khripkinvlan/OvcharkaBoard/Безымянный проект/Безымянный проект.png

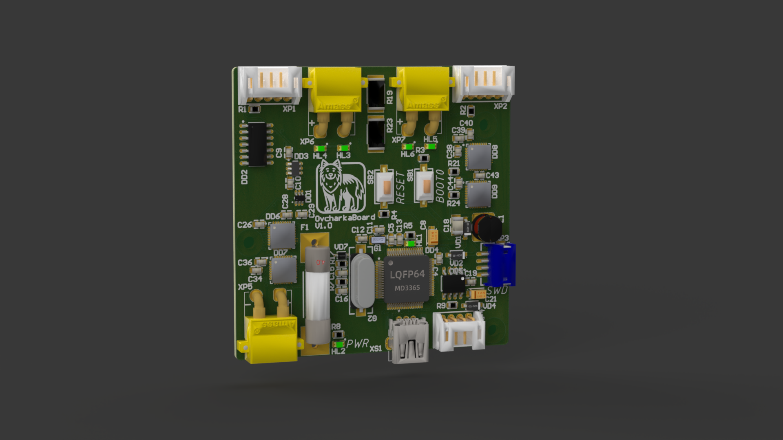
Безымянный проект/Безымянный проект.png
