khripkinvlan/OvcharkaBoard/CubeMxProject/Pinout.xlsx

Pin Nb | PINs | FUNCTIONs | LABELs | Pin Nb | PINs | FUNCTIONs | LABELs
1 | VBAT |  |  | 1 | VBAT
2 | PC13-TAMPER-RTC | GPIO_Output | IND_LED | 2 | PC13-TAMPER-RTC | GPIO_Output | IND_LED
3 | PC14-OSC32_IN | RCC_OSC32_IN |  | 3 | PC14-OSC32_IN
4 | PC15-OSC32_OUT | RCC_OSC32_OUT |  | 4 | PC15-OSC32_OUT
5 | PD0-OSC_IN | RCC_OSC_IN |  | 5 | PD0-OSC_IN | RCC_OSC_IN
6 | PD1-OSC_OUT | RCC_OSC_OUT |  | 6 | PD1-OSC_OUT | RCC_OSC_OUT
7 | NRST | RESET |  | 7 | NRST | RESET
8 | VSSA | GND |  | 8 | VSSA | GND
9 | VDDA | 3V3 |  | 9 | VDDA | 3V3
10 | PA0-WKUP | TIM2_CH1 | ENC2_CH1 | 10 | PA0-WKUP |  | DIR1
11 | PA1 | TIM2_CH2 | ENC2_CH2 | 11 | PA1 |  | DIR2
12 | PA2 | ADC1_IN2 | CS1 | 12 | PA2 | ADC1_IN2 | CS1
13 | PA3 | ADC1_IN3 | CS2 | 13 | PA3 | ADC1_IN3 | CS2
14 | PA4 | GPIO_Output | SPI1_SS1 | 14 | PA4 | GPIO_Output | SPI1_SS1
15 | PA5 | SPI1_SCK |  | 15 | PA5 | SPI1_SCK
16 | PA6 | SPI1_MISO |  | 16 | PA6 | SPI1_MISO
17 | PA7 | SPI1_MOSI |  | 17 | PA7 | SPI1_MOSI
18 | PB0 | TIM3_CH3 | PWM1 | 18 | PB0 | TIM3_CH3 | PWM1
19 | PB1 | TIM3_CH4 | PWM2 | 19 | PB1 | TIM3_CH4 | PWM2
20 | PB2 | GPIO_Output | SPI1_SS2 | 20 | PB2 | GPIO_Output | SPI1_SS2
21 | PB10 | GPIO_Output | SPI1_SS3 | 21 | PB10 | GPIO_Output | SPI1_SS3
22 | PB11 | GPIO_Output | SPI1_SS4 | 22 | PB11 | GPIO_Output | SPI1_SS4
23 | VSS |  |  | 23 | VSS | GND
24 | VDD |  |  | 24 | VDD | 3V3
25 | PB12 | GPIO_Input | NFAULT1L | 25 | PB12 | GPIO_Input | BRIDGESLEEP1
26 | PB13 | GPIO_Input | NFAULT1R | 26 | PB13 | GPIO_Input | BRIDGESLEEP2
27 | PB14 | GPIO_Input | NFAULT2L | 27 | PB14 | GPIO_Input | NFAULTA
28 | PB15 | GPIO_Input | NFAULT2R | 28 | PB15 | GPIO_Input | NFAULTB
29 | PA8 | TIM1_CH1 | ENC1_CH2 | 29 | PA8 | TIM1_CH1 | ENC1_CH1
30 | PA9 | TIM1_CH2 | ENC1_CH1 | 30 | PA9 | TIM1_CH2 | ENC1_CH2
31 | PA10 | GPIO_Output | CAN_MODE | 31 | PA10 | GPIO_Input | ENC1_Z
32 | PA11 | CAN_RX |  | 32 | PA11 | GPIO_Input | ENC2_Z
33 | PA12 | CAN_TX |  | 33 | PA12 |  | DRVOFF1
34 | PA13 | SYS_JTMS-SWDIO |  | 34 | PA13 | SYS_JTMS-SWDIO
35 | VSS |  |  | 35 | VSS
36 | VDD |  |  | 36 | VDD
37 | PA14 | SYS_JTCK-SWCLK |  | 37 | PA14 | SYS_JTCK-SWCLK
38 | PA15 | GPIO_Input | ENC2_Z | 38 | PA15 | TIM2_CH1 | ENC2_CH1
39 | PB3 | GPIO_Input | ENC1_Z | 39 | PB3 | TIM2_CH2 | ENC2_CH2
40 | PB4 | GPIO_Output | 3 | 40 | PB4 | GPIO_Output | DRVOFF2
41 | PB5 | GPIO_Output | DIS1 | 41 | PB5 | GPIO_Output | RS485_Ctrl
42 | PB6 | GPIO_Output | DIR2 | 42 | PB6 | USART1_TX
43 | PB7 | GPIO_Output | DIS2 | 43 | PB7 | USART1_RX
44 | BOOT0 |  |  | 44 | BOOT0
45 | PB8 | TIM4_CH3 | ENC2_CH1_F | 45 | PB8 | TIM4_CH3 | ENC1_CH1_F
46 | PB9 | TIM4_CH4 | ENC1_CH1_F | 46 | PB9 | TIM4_CH4 | ENC2_CH1_F
47 | VSS | GND |  | 47 | VSS | GND
48 | VDD | 3V3 |  | 48 | VDD | 3V3
