khripkinvlan/OvcharkaBoard/FunctionalSchemeEN.png

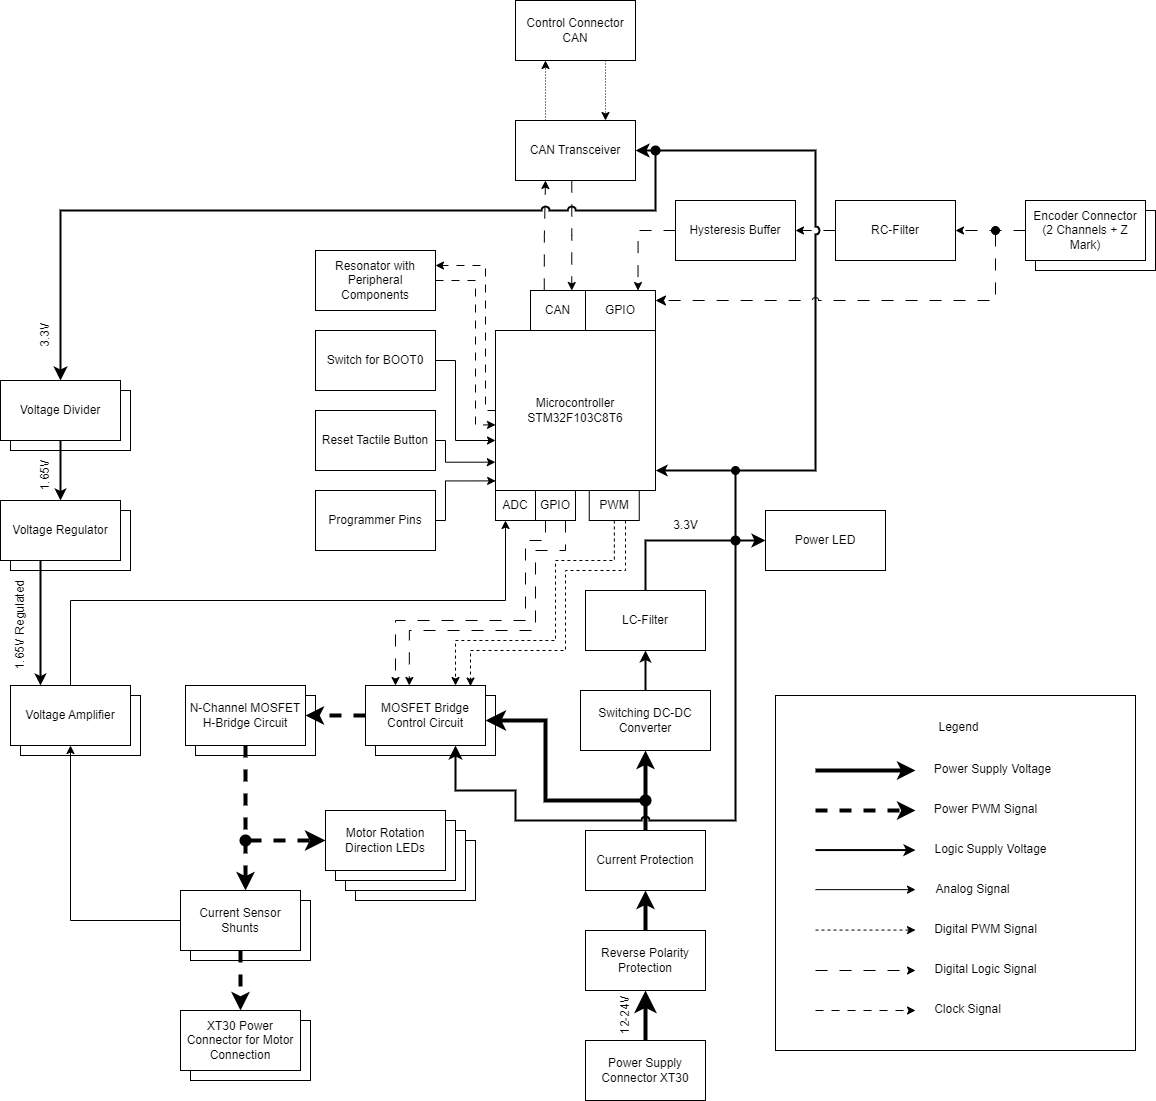
FunctionalSchemeEN.png
