khripkinvlan/OvcharkaBoard/FunctionalSchemeRU.png

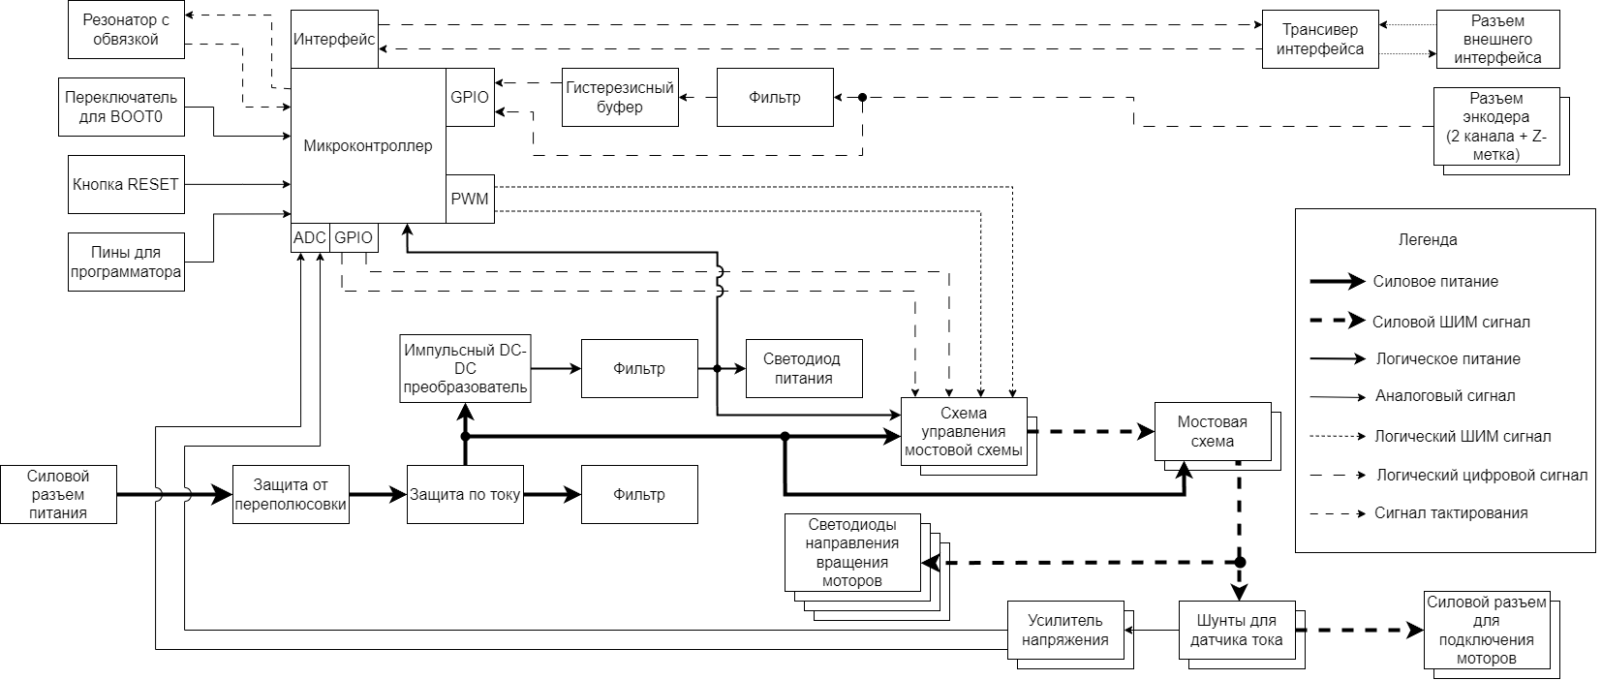
FunctionalSchemeRU.png
