khripkinvlan/OvcharkaBoard/OvcharkaBoard.png

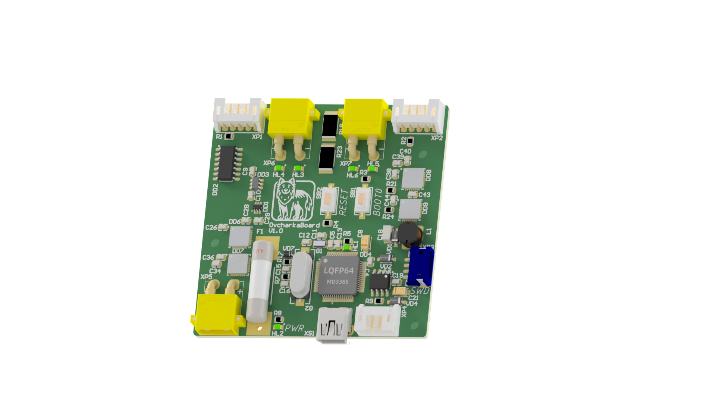
OvcharkaBoard.png
