khripkinvlan/OvcharkaBoard/Schemes/sosa-1.png

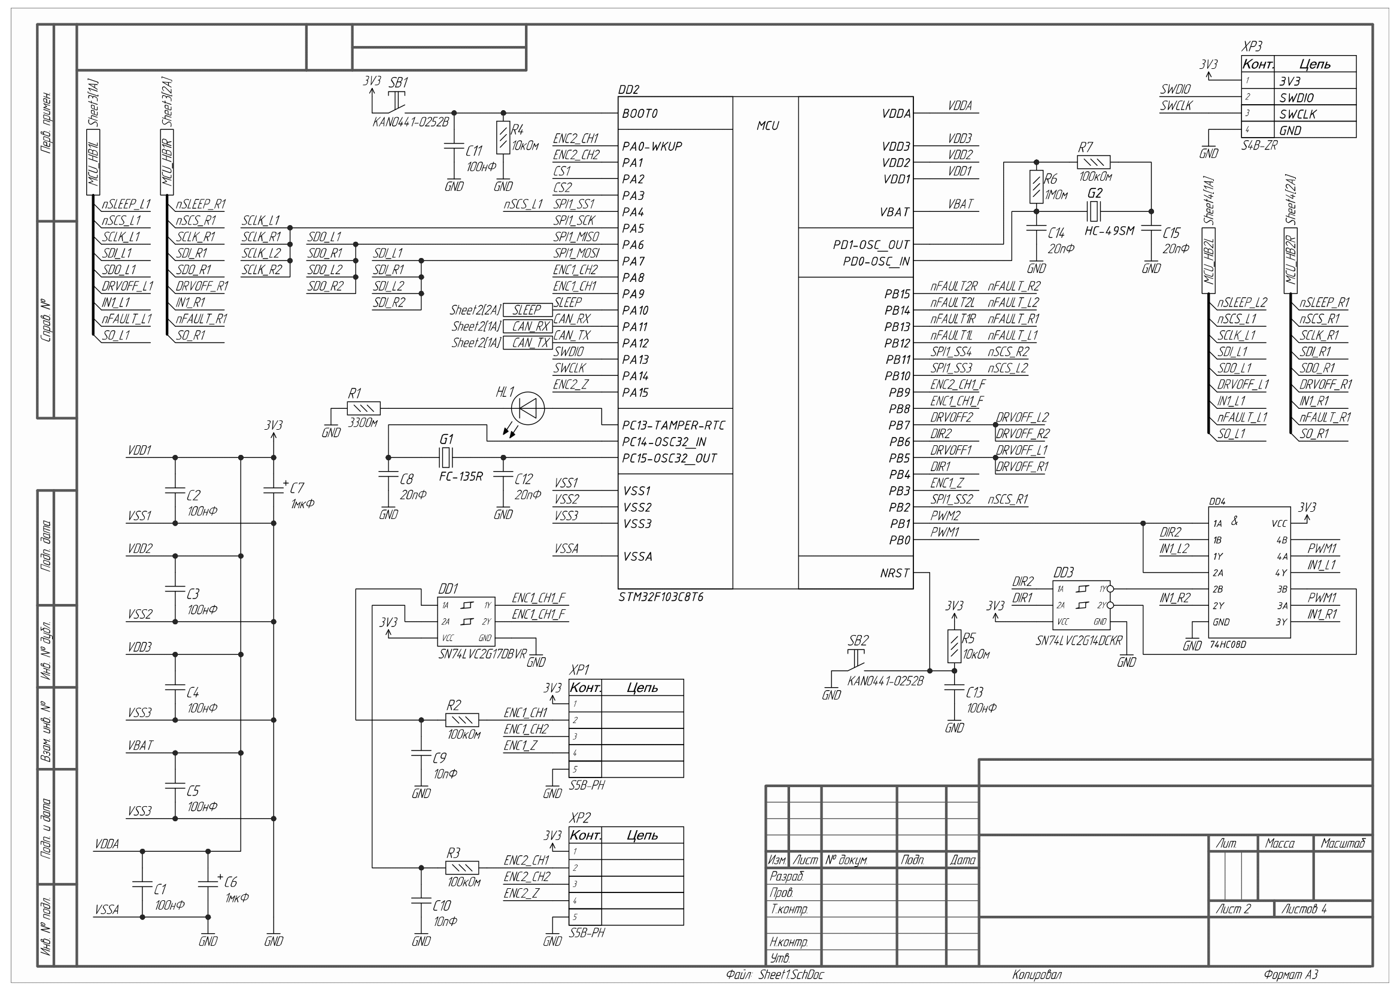
Schemes/sosa-1.png
