khripkinvlan/OvcharkaBoard/Без имени.png

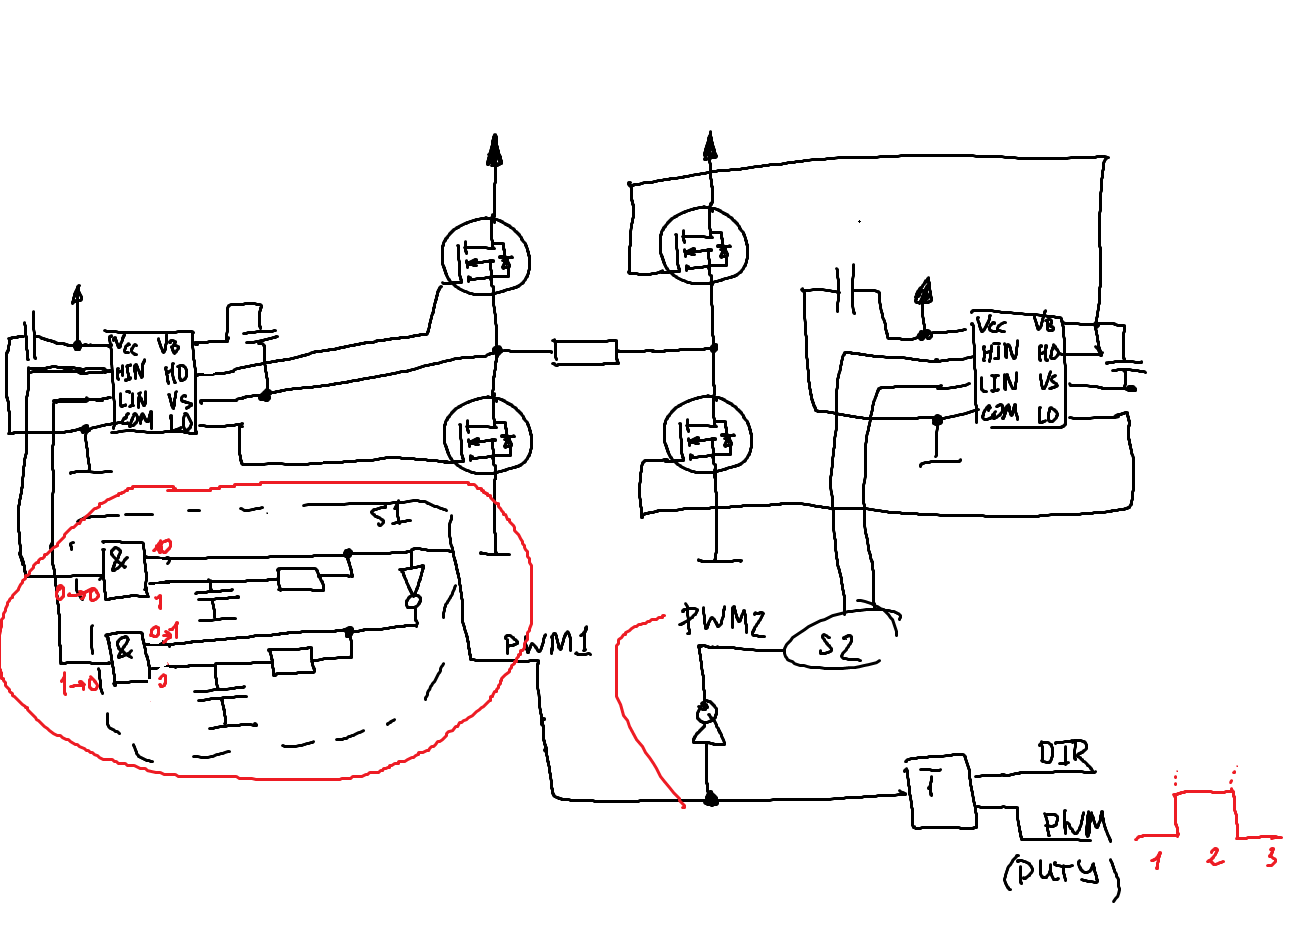
Без имени.png
