khripkinvlan/OvcharkaBoard/Инвентаризация 23.02.2025.xlsx

Line # | Name | Description | Designator | Quantity | 2BoardRequire | InStock | Extra | В корзине | Price | Подходит ли посадочное место | Правильная ли распиновка
 | AMS1117-3.3 | Линейный регулятор с малым падением напряжения, 1А, 3.3В [SOT-223] | A1 | 1 | 2 | 6 | 4 |  |  |  |  | 6
 | 0,1мкФ 50В | Конденсатор керамический, типоразмера 0603 | C1, C2, C3, C4, C5, C6, C13, C14, C19, C24, C27, C28, C36, C39, C44 | 15 | 30 | 30 | 0 |  |  |  |  | 2
 | 1мкФ | Описание свойств компонента | C7, C8, C21 | 3 | 6 | 4 | -2 | 8 |  |  |  | 1.333333333
 | 1мкФ 50В | Описание свойств компонента | C25, C26 ,C29, C33, C34, C35, C37, C38, C40, C41, C42, C43 | 11 | 22 | 15 | -7 |  |  |  |  | 1.363636364
 | 10пФ | Конденсатор керамический, типоразмера 0603 | C9, C10 | 2 | 4 | 4 | 0 |  |  |  |  | 2
 | 20пФ | Конденсатор керамический, типоразмера 0603 | C11, C12, C15, C16 | 4 | 8 | 6 | -2 |  |  |  |  | 1.5
 | 10мкФ 50В | Конденсатор керамический, типоразмера 1206 | C17, C18, C22, C23, C30, C31, C32 | 7 | 14 | 13 | -1 |  |  |  |  | 1.857142857
 | 3.9нФ | Конденсатор керамический, типоразмера 0603 | C20 | 1 | 2 | 3 | 1 |  |  |  |  | 3
 | MC34063S | The MC34063is a monolithic regulator subsystem, intended for use as DC to DC converter. This device contains a temperature compensated band gap reference, a duty-cycle control oscillator, driver and high current output switch. It can be used for step down, step-up or inverting switching regulators as well as for series pass regulators. | DA1 | 1 | 2 | 8 | 6 |  |  | Да |  | 8
 | SN74LVC2G14DCKR | Сдвоенный инвертор с триггером Шмидта | DD1 | 1 | 2 | 3 | 1 |  |  |  |  | 3
 | 74HC08D | Логическая ИС, QUAD 2-INPUT AND GATE | DD2 | 1 | 2 | 3 | 1 |  |  |  |  | 3
 | SN74LVC2G17DBVR | Сдвоенный буфер с триггером Шмитта на входе | DD3 | 1 | 2 | 3 | 1 |  |  |  |  | 3
 | STM32F103RBT6 | Микроконтроллер 32-Бит, Cortex-M3, 72МГц, 128КБ Flash, USB, CAN [LQFP-64] | DD4 | 1 | 2 | 1 | -1 |  |  |  |  | 1
 | SP3485EN-L/TR | Трансивер RS485 Half-Duplex 1/1 | DD5 | 1 | 2 | 0 | -2 |  |  | Да |  | 0
 | DRV8106SQRHBRQ1 | Automotive, 40-V, half-bridge Smart Gate Driver w/offline diagnostics and inline current sense amp. | DD6, DD7, DD8, DD9 | 4 | 8 | 10 | 2 |  |  |  |  | 2.5
 | ва | Предохранитель плавкий 5x20 | F1 | 1 | 2 | 1 | -1 |  |  |  |  | 1
 | FC-135R | Кварцевый резонатор 32,768 кГц; SMD | G1 | 1 | 2 | 2 | 0
 | HC-49SM | Кварцевый резонатор 8 МГц; SMD | G2 | 1 | 2 | 2 | 0 |  |  |  |  | 2
 | 3 | Светодиод SMD 0805=2x1.3мм, красный, 28мкд, 130град, прозрачная линза; Q-15575B СД SMD02013C2\кр\ 28,5\130\пр\FYLS- 0805HD\FORYARD | HL1, HL2, HL3, HL4, HL5, HL6 | 6 | 12 | 88 | 76 |  |  |  |  | 14.66666667
 | 47мкГн | Дросель, 5x5 | L1 | 1 | 2 | 13 | 11 |  |  |  |  | 13
 | 100кОм | Резистор, типоразмера 0603 | R1, R2, R7, R15 | 4 | 8 | 5 | -3 |  |  |  |  | 1.25
 | 10кОм | Резистор, типоразмера 0603 | R3, R4, R16, R17, R20, R21, R24 | 7 | 14 | 9 | -5 |  |  |  |  | 1.285714286
 | 1МОм | Резистор, типоразмера 0603 | R6 | 1 | 2 | 8 | 6 |  |  |  |  | 8
 | 330Ом | Резистор, типоразмера 0603 | R5,R8 | 2 | 4 | 8 | 4 |  |  |  |  | 4
 | 120Ом | Резистор, типоразмера 0603 | R9 | 1 | 2 | 17 | 15 |  |  |  |  | 17
 | 4.7кОм | Резистор, типоразмера 0603 | R10, R11 | 2 | 4 | 18 | 14 |  |  |  |  | 9
 | 8.2кОм 1% | Резистор, типоразмера 0603 | R12 | 1 | 2 | 9 | 7 |  |  |  |  | 9
 | 4,99 кОм 1% | Резистор, типоразмера 0603 | R13 | 1 | 2 | 9 | 7 |  |  |  |  | 9
 | 0.2Ом 1% | Резистор, типоразмера 2512 | R14 | 1 | 2 | 4 | 2 |  |  |  |  | 4
 | 7.5мОм | Резистор, типоразмера 2512 | R18, R22 | 2 | 4 | 48 | 44 |  |  |  |  | 24
 | 1.8кОм | Резистор, типоразмера 2512 | R19, R23 | 2 | 4 | 4 | 0 |  |  |  |  | 2
 | KAN0441-0252B | Описание свойств компонента | SB1, SB2 | 2 | 4 | 100 | 96 |  |  |  |  | 50
 | USBLC6-2 | Защита интерфейса USB от электростатических разрядов [SOT-23-6] | V1 | 1 | 2 | 3 | 1 |  |  |  |  | 3
 | 1N5819W | Диод Шоттки, 40 В, 0.35 А, SOD-123 | VD1, VD2, VD4, VD5 | 4 | 8 | 46 | 38 |  |  | Да |  | #REF!
 | ESDCAN24-2BLY | Устройство защиты CAN шины от ESD, 2 защитных диода [SOT-23-3] | VD3 | 1 | 2 | 4 | 2 |  |  |  |  | 4
 | ESD5Z5.0T1G | Устройство защиты от ESD, защитный диод, 5В [SOD-523] | VD6 | 1 | 2 | 10 | 8 |  |  |  |  | 10
 | BZX384-C18 | Стабилитрон 18В 0.3Вт [SOD-323] | VD7 | 1 | 2 | 66 | 64 |  |  |  |  | 66
 | STD10PF06T4-VB | Транзистор P-MOSFET 60В 30А 34Вт [D-PAK] | VT1 | 1 | 2 | 9 | 7 |  |  |  |  | 9
 | IRF7854TRPBF | Транзистор, HEXFET, N-канал, 80В, 10А [SOIC-8] | VT2, VT3, VT4, VT5, VT6, VT7, VT8, VT9 | 8 | 16 | 4 | -12 |  |  | Да |  | 0.5
 | S5B-PH | JST PH 5pin 2 mm pitch; horizontal; through hole OR full smd; S5B-PH-SM4-TB | XP1, XP2 | 2 | 4 | 16 | 12 |  |  | Да |  | 8
 | S4B-ZR | JST ZH 4pin 1.5 mm pitch; horizontal; through hole OR full smd; S4B-ZR | XP3 | 1 | 2 | 15 | 13 |  |  |  |  | 15
 | S4B-PH | JST PH 4pin 2 mm pitch; horizontal; through hole OR full smd; S4B-PH-SM4-TB | XP4 | 1 | 2 | 4 | 2 |  |  |  |  | 4
 | XT30PW-M | Socket; DC supply; XT30; male; PIN: 2; on PCBs; THT; yellow; 15A; 500V | XP5, XP6, XP7 | 3 | 6 | 1 | -5 |  |  |  |  | 0.3333333333
 | 0548190519 | USB - mini B USB 2.0 OTG Receptacle Connector 5 Position Through Hole, Right Angle | XS1 | 1 | 2 | 5 | 3 |  |  |  |  | 5
 | 470 Ом | Резистор, типоразмера 0603 | R8 | 1 | 2 | 7 | 5 |  |  |  |  | 7
