khripkinvlan/OvcharkaBoard/bomchik.xlsx

Line # | Name | Description | Designator | Quantity | 2BoardRequire | Bought | Extra | Supplier | Price | Подходит ли посадочное место | Правильная ли распиновка
 | 100нФ | Конденсатор керамический, типоразмера 0603 | C1, C2, C3, C4, C5, C9, C13, C19 | 8 | 16 |  | -16 |  |  |  |  | 0
 | 1мкФ | Описание свойств компонента | C6, C7, C20 | 3 | 6 |  | -6 |  |  |  |  | 0
 | 20пФ | Конденсатор керамический, типоразмера 0603 | C8, C12, C14, C15 | 4 | 8 |  | -8 |  |  |  |  | 0
 | 10пФ | Конденсатор керамический, типоразмера 0603 | C10, C11 | 2 | 4 |  | -4 |  |  |  |  | 0
 | 10мкФ 50В | Конденсатор керамический, типоразмера 1206 | C16, C17, C21, C22, C28, C29, C30 | 7 | 14 |  | -14 |  |  |  |  | 0
 | 3.9нФ | Конденсатор керамический, типоразмера 0603 | C18 | 1 | 2 |  | -2 |  |  |  |  | 0
 | 1мкФ 6.3В | Конденсатор керамический, типоразмера 0603 | C23, C24, C31, C32, C35, C36, C39, C40 | 8 | 16 |  | -16 |  |  |  |  | 0
 | 0,1мкФ 50 В | Конденсатор керамический, типоразмера 0603 | C25, C26, C34, C37, C42 | 5 | 10 |  | -10 |  |  |  |  | 0
 | 1мкФ 16 В | Конденсатор керамический, типоразмера 0603 | C27, C33, C38, C41 | 4 | 8 |  | -8 |  |  |  |  | 0
 | MC34063S | The MC34063is a monolithic regulator subsystem, intended for use as DC to DC converter. This device contains a temperature compensated band gap reference, a duty-cycle control oscillator, driver and high current output switch. It can be used for step down, step-up or inverting switching regulators as well as for series pass regulators. | DA1 | 1 | 2 | 10 | 8 | Aliexpress |  | Да |  | 10
 | SN74LVC2G17DBVR | Сдвоенный буфер с триггером Шмитта на входе | DD1 | 1 | 2 |  | -2 |  |  |  |  | 0
 | STM32F103C8T6 | Medium-density performance line Arm®-based 32-bit MCU with 64 or 128 KB Flash, USB, CAN, 7 timers, 2 ADCs, 9 com. interfaces | DD2 | 1 | 2 | 10 | 8 | Aliexpress |  | Да |  | 10
 | SN74LVC2G14DCKR | Сдвоенный инвертор с триггером Шмидта | DD3 | 1 | 2 |  | -2 |  |  |  |  | 0
 | 74HC08D | Логическая ИС, QUAD 2-INPUT AND GATE | DD4 | 1 | 2 |  | -2 |  |  |  |  | 0
 | SP3485EN-L/TR | Трансивер RS485 Half-Duplex 1/1 | DD5 | 1 | 2 | 5 | 3 | ТомЭлектрон |  | Да |  | 5
 | SN74HC148DR | Шифратор с 8-и до 3-х линий передачи данных [SO-16] | DD6 | 1 | 2 |  | -2 |  |  |  |  | 0
 | DRV8106SQRHBRQ1 | Automotive, 40-V, half-bridge Smart Gate Driver w/offline diagnostics and inline current sense amp. | DD7, DD8, DD9, DD10 | 4 | 8 |  | -8 |  |  |  |  | 0
 | ва | Предохранитель плавкий 5x20 | F1 | 1 | 2 |  | -2 |  |  |  |  | 0
 | FC-135R | Кварцевый резонатор 32,768 кГц; SMD | G1 | 1 | 2 |  | -2 |  |  |  |  | 0
 | HC-49SM | Кварцевый резонатор 8 МГц; SMD | G2 | 1 | 2 | 3 | 1 | ТомЭлектрон |  |  |  | 3
 | 3 | Светодиод оранжевый SMD 0805=2x1.3мм, 70мКд, 130°, 625нм (Orange); №7339 o СД SMD02013C2\оран\ 70\130\пр\FYLS-0805UEC\ | HL1 | 1 | 2 | 100 | 98 |  |  |  |  | 100
 | 3 | Светодиод SMD 0805=2x1.3мм, красный, 28мкд, 130град, прозрачная линза; Q-15575B СД SMD02013C2\кр\ 28,5\130\пр\FYLS- 0805HD\FORYARD | HL2 | 1 | 2 | 100 | 98 |  |  |  |  | 100
 | 3 | Светодиод SMD 0805=2x1.3мм, красный, 28мкд, 130град, прозрачная линза; Q-15575B СД SMD02013C2\кр\ 28,5\130\пр\FYLS- 0805HD\FORYARD | HL3, HL4, HL5, HL6 | 4 | 8 | 100 | 92 |  |  |  |  | 25
 | 47мкГн | Дросель, типоразмера 2010 | L1 | 1 | 2 |  | -2 |  |  |  |  | 0
 | 330Ом | Резистор, типоразмера 0603 | R1, R8 | 2 | 4 |  | -4 |  |  |  |  | 0
 | 100кОм | Резистор, типоразмера 0603 | R2, R3, R7 | 3 | 6 |  | -6 |  |  |  |  | 0
 | 10кОм | Резистор, типоразмера 0603 | R4, R5, R15, R16, R19, R20, R23 | 7 | 14 |  | -14 |  |  |  |  | 0
 | 1МОм | Резистор, типоразмера 0603 | R6 | 1 | 2 |  | -2 |  |  |  |  | 0
 | 120Ом | Резистор, типоразмера 0603 | R9 | 1 | 2 |  | -2 |  |  |  |  | 0
 | 8.2кОм 1% | Резистор, типоразмера 0603 | R10 | 1 | 2 |  | -2 |  |  |  |  | 0
 | 4.7кОм | Резистор, типоразмера 0603 | R11, R12 | 2 | 4 |  | -4 |  |  |  |  | 0
 | 5кОм 1% | Резистор, типоразмера 0603 | R13 | 1 | 2 |  | -2 |  |  |  |  | 0
 | 0.2Ом 1% | Резистор, типоразмера 2512 | R14 | 1 | 2 |  | -2 |  |  |  |  | 0
 | 7.5мОм | Резистор, типоразмера 2512 | R17, R21 | 2 | 4 | 50 | 46 |  |  |  |  | 25
 | 1.8кОм | Резистор, типоразмера 2512 | R18, R22 | 2 | 4 |  | -4 |  |  |  |  | 0
 | KAN0441-0252B | Описание свойств компонента | SB1, SB2 | 2 | 4 |  | -4 |  |  |  |  | 0
 | 1N5819W | Диод Шоттки, 40 В, 0.35 А, SOD-123 | VD1, VD2, VD4 | 3 | 6 | 50 | 44 |  |  | Да |  | 16.66666667
 | ESDCAN24-2BLY | Устройство защиты CAN шины от ESD, 2 защитных диода [SOT-23-3] | VD3 | 1 | 2 |  | -2 |  |  |  |  | 0
 | BZX384-C18 | Стабилитрон 18В 0.3Вт [SOD-323] | VD5 | 1 | 2 |  | -2 |  |  |  |  | 0
 | STD10PF06T4-VB | Транзистор P-MOSFET 60В 30А 34Вт [D-PAK] | VT1 | 1 | 2 |  | -2 |  |  |  |  | 0
 | IRF7854TRPBF | Транзистор, HEXFET, N-канал, 80В, 10А [SOIC-8] | VT2, VT3, VT4, VT5, VT6, VT7, VT8, VT9 | 8 | 16 | 20 | 4 |  |  | Да |  | 2.5
 | S5B-PH | JST PH 5pin 2 mm pitch; horizontal; through hole OR full smd; S5B-PH-SM4-TB | XP1, XP2 | 2 | 4 | 20 | 16 | Aliexpress |  |  |  | 10
 | S4B-ZR | JST ZH 4pin 1.5 mm pitch; horizontal; through hole OR full smd; S4B-ZR | XP3 | 1 | 2 | 15 | 13 | Aliexpress |  |  |  | 15
 | S4B-PH | JST PH 4pin 2 mm pitch; horizontal; through hole OR full smd; S4B-PH-SM4-TB | XP4 | 1 | 2 | 10 | 8 |  |  |  |  | 10
 | XT30PW-M | Socket; DC supply; XT30; male; PIN: 2; on PCBs; THT; yellow; 15A; 500V | XP5, XP6, XP7 | 3 | 6 | 7 | 1 |  |  |  |  | 2.333333333
 | XT30-M |  |  |  |  | 10 | 10 | Aliexpress
 | XT30-F |  |  |  |  | 10 | 10 | Aliexpress
 | AMS1117-3.3 | Линейный регулятор с малым падением напряжения, 1А, 3.3В [SOT-223] | A1 | 1
