khripkinvlan/OvcharkaBoard/OvcharkaBoard/Project Outputs for OvcharkaBoard/cam.dxf

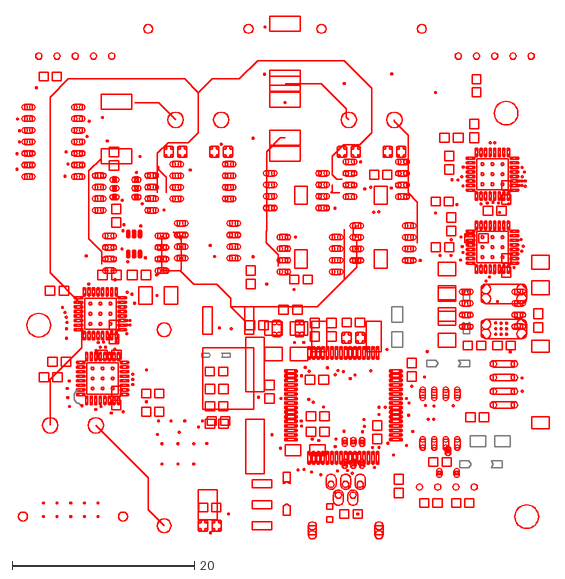
[picture p12: CAD file, 2025-01-27]
OvcharkaBoard/Project Outputs for OvcharkaBoard/cam.dxf
58.5 x 57.3
