khripkinvlan/OvcharkaBoard/Schemes/Schemes.pdf

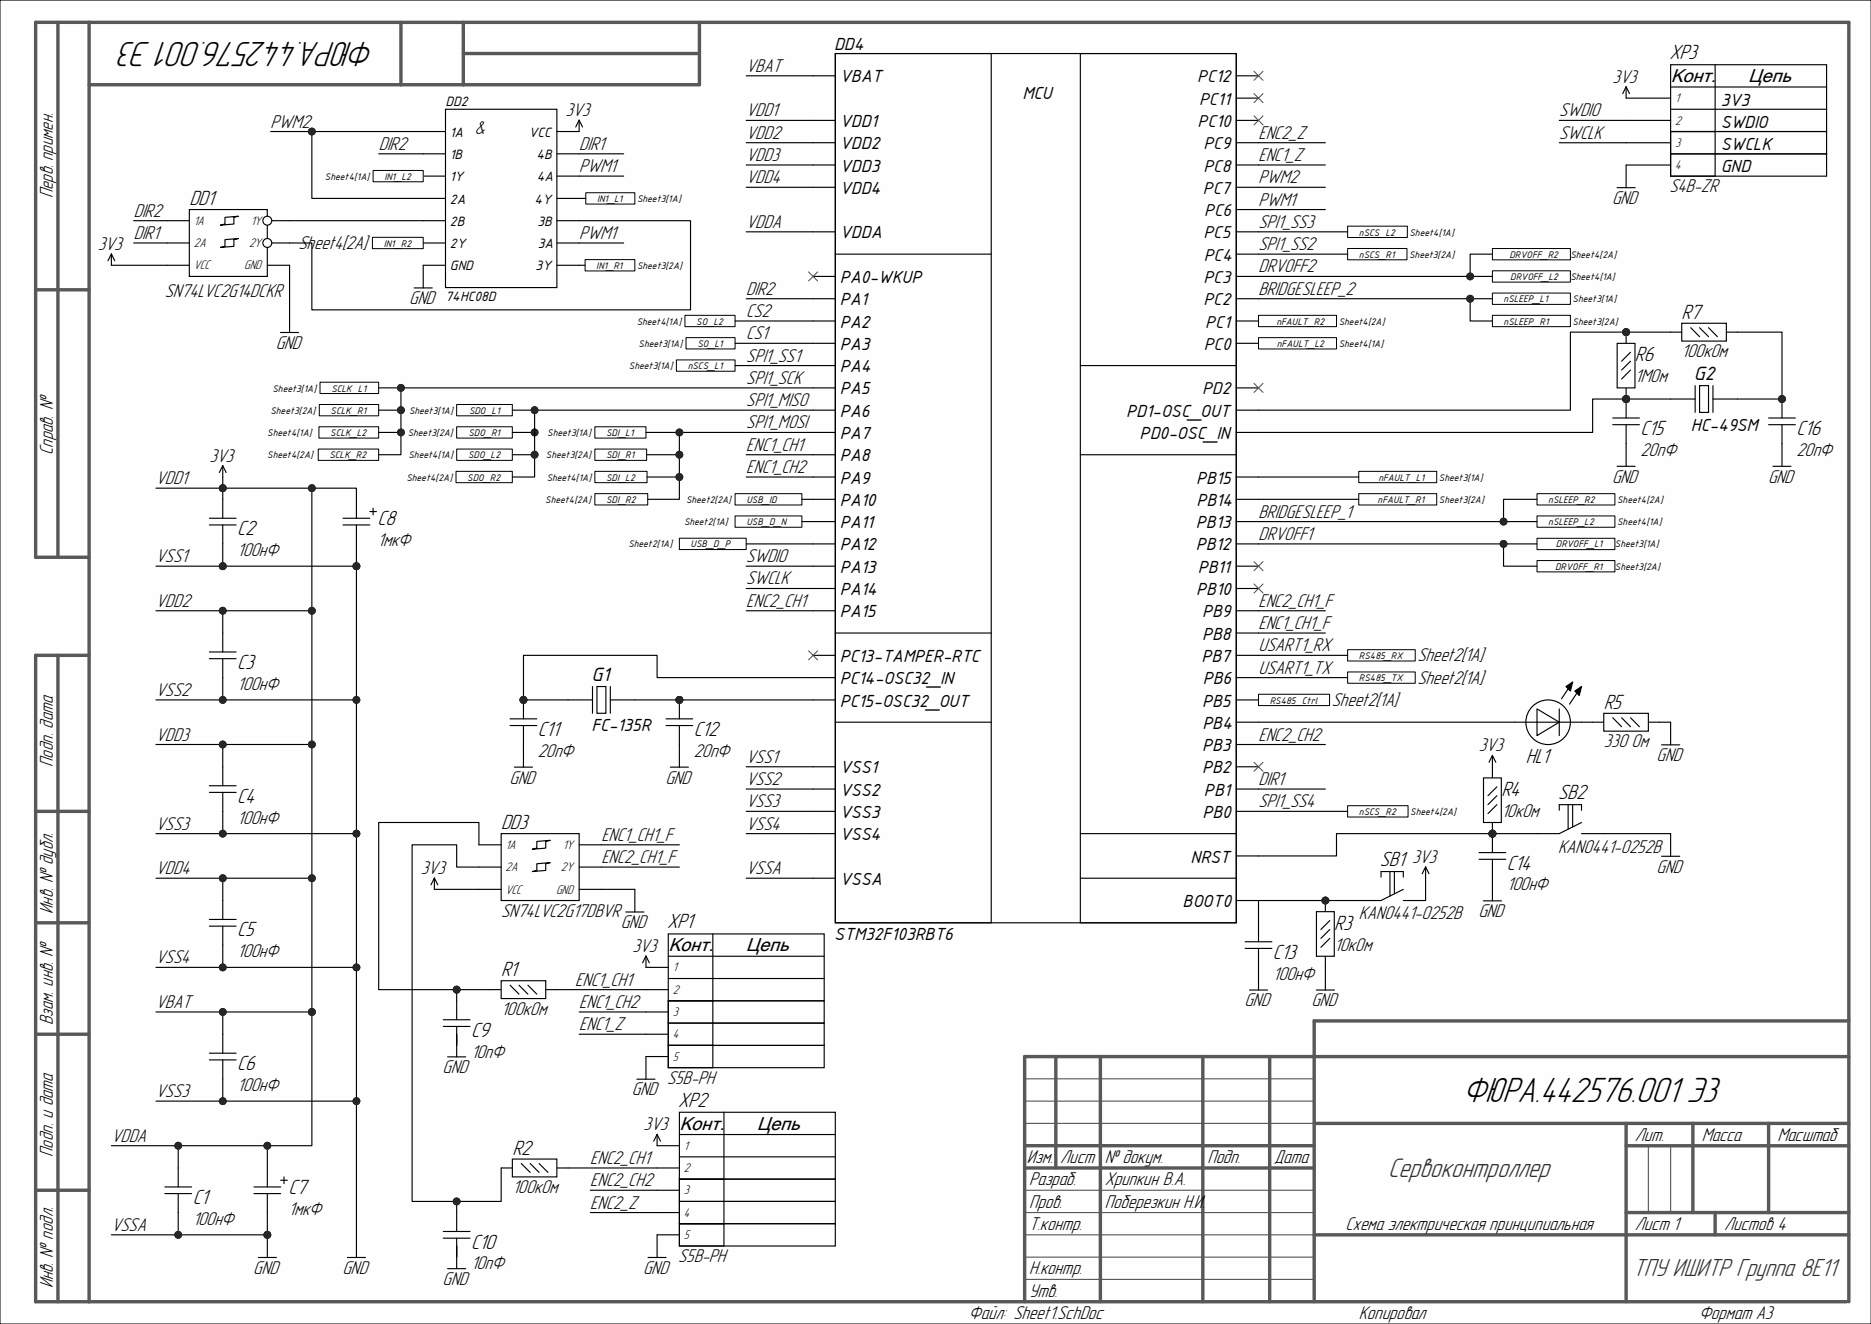
[picture p13: page 1]

ФЮРА.442576.001 Э3

Сервоконтроллер Схема электрическая принципиальная | Лит. | Масса | Масштаб

Изм. Лист № докум. | | Подп. | Дата
Разраб. | Хрипкин В.А.

Т.контр. | Лист 1 4 | Листов

Н.контр.
Утв.

ТПУ ИШИТР Группа 8Е11

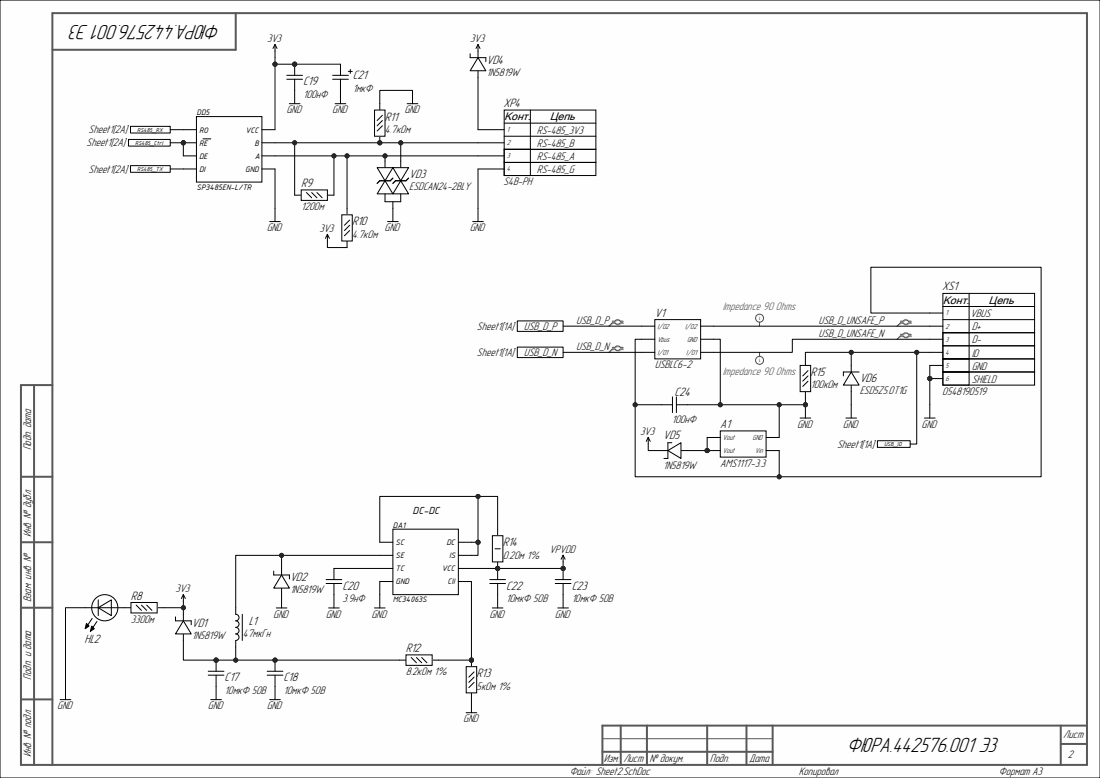
[picture p14: page 2]

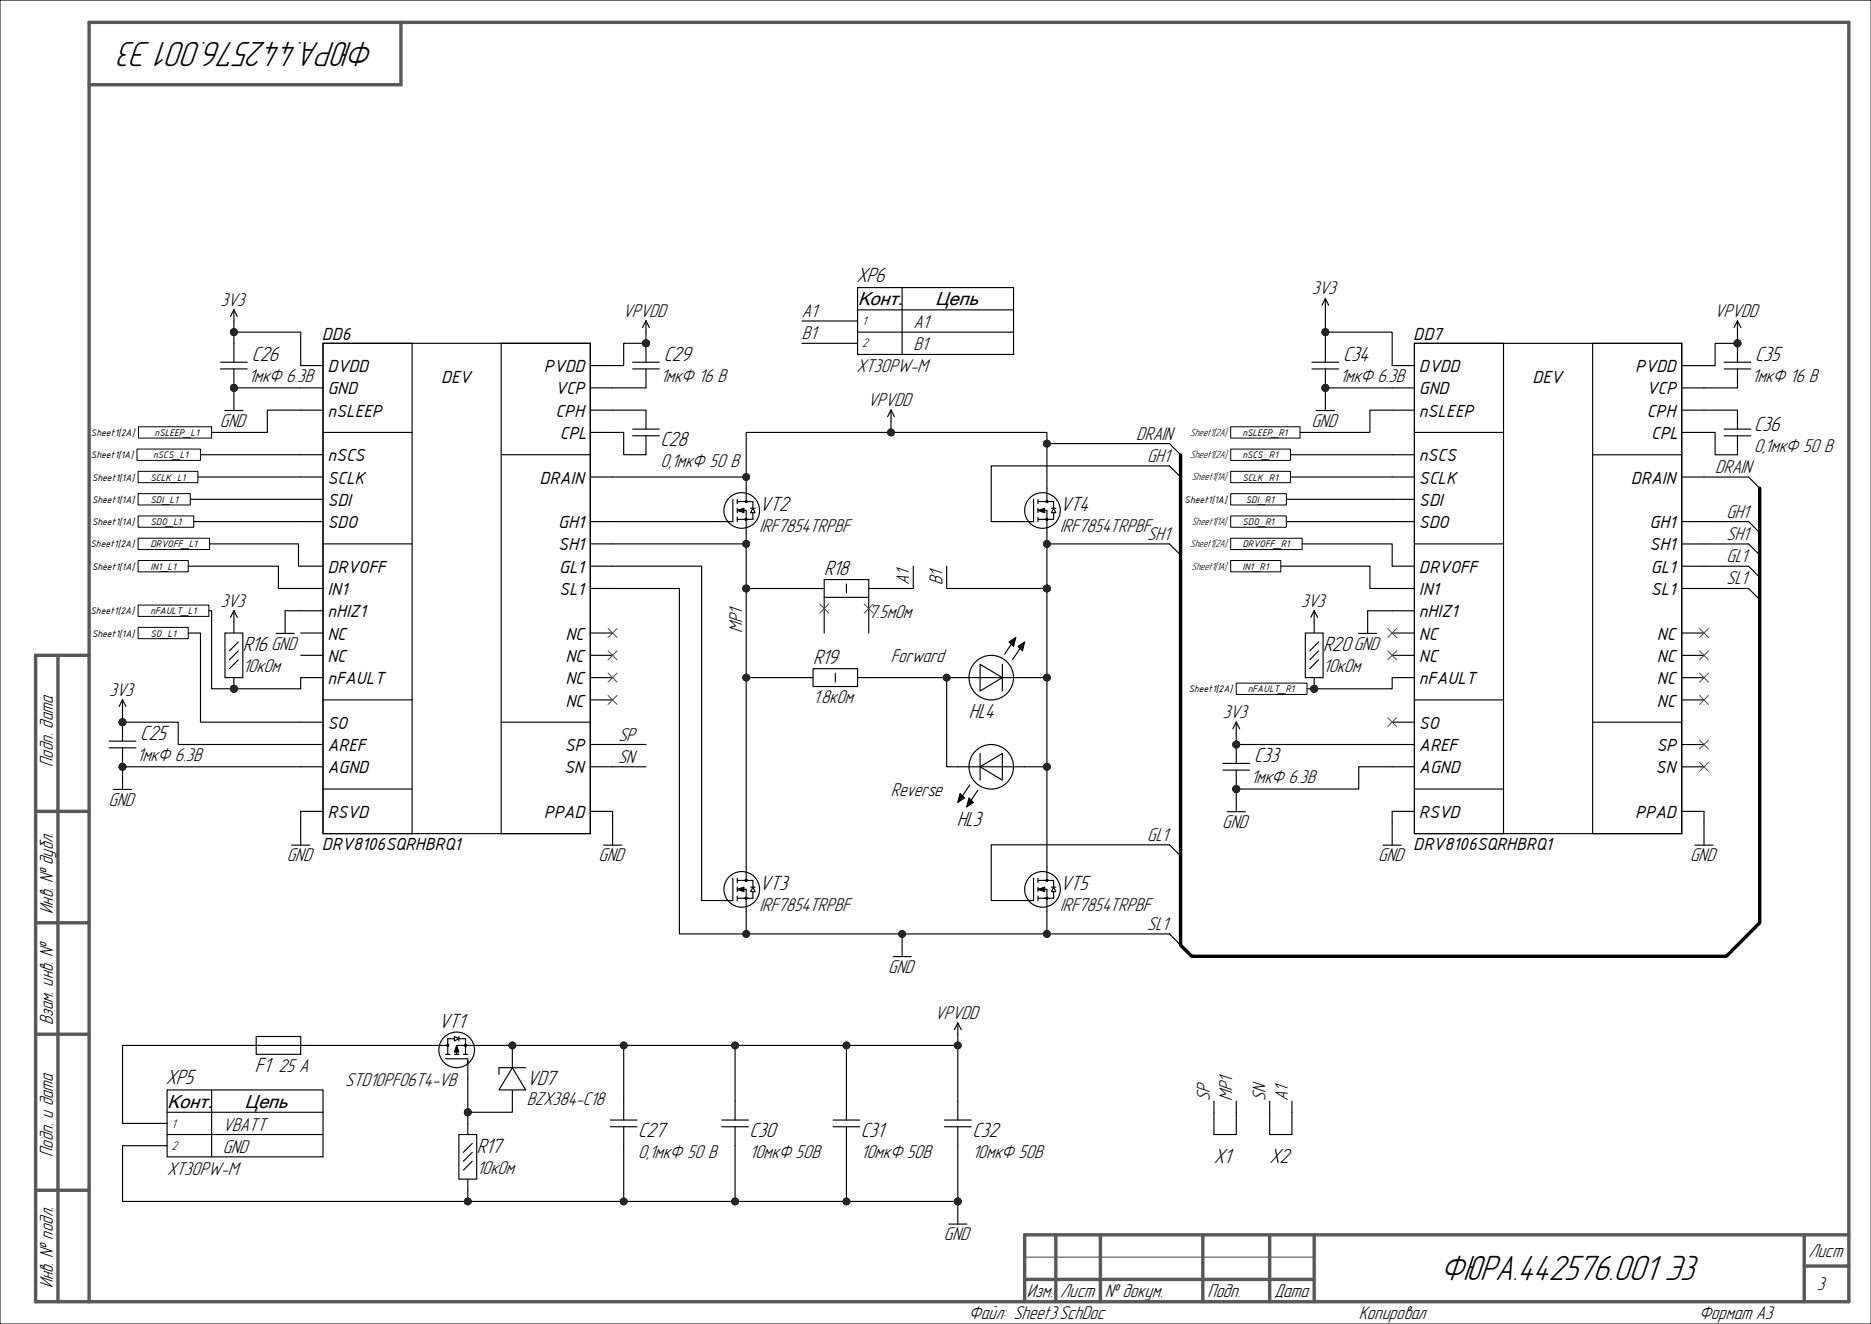
[picture p15: page 3]

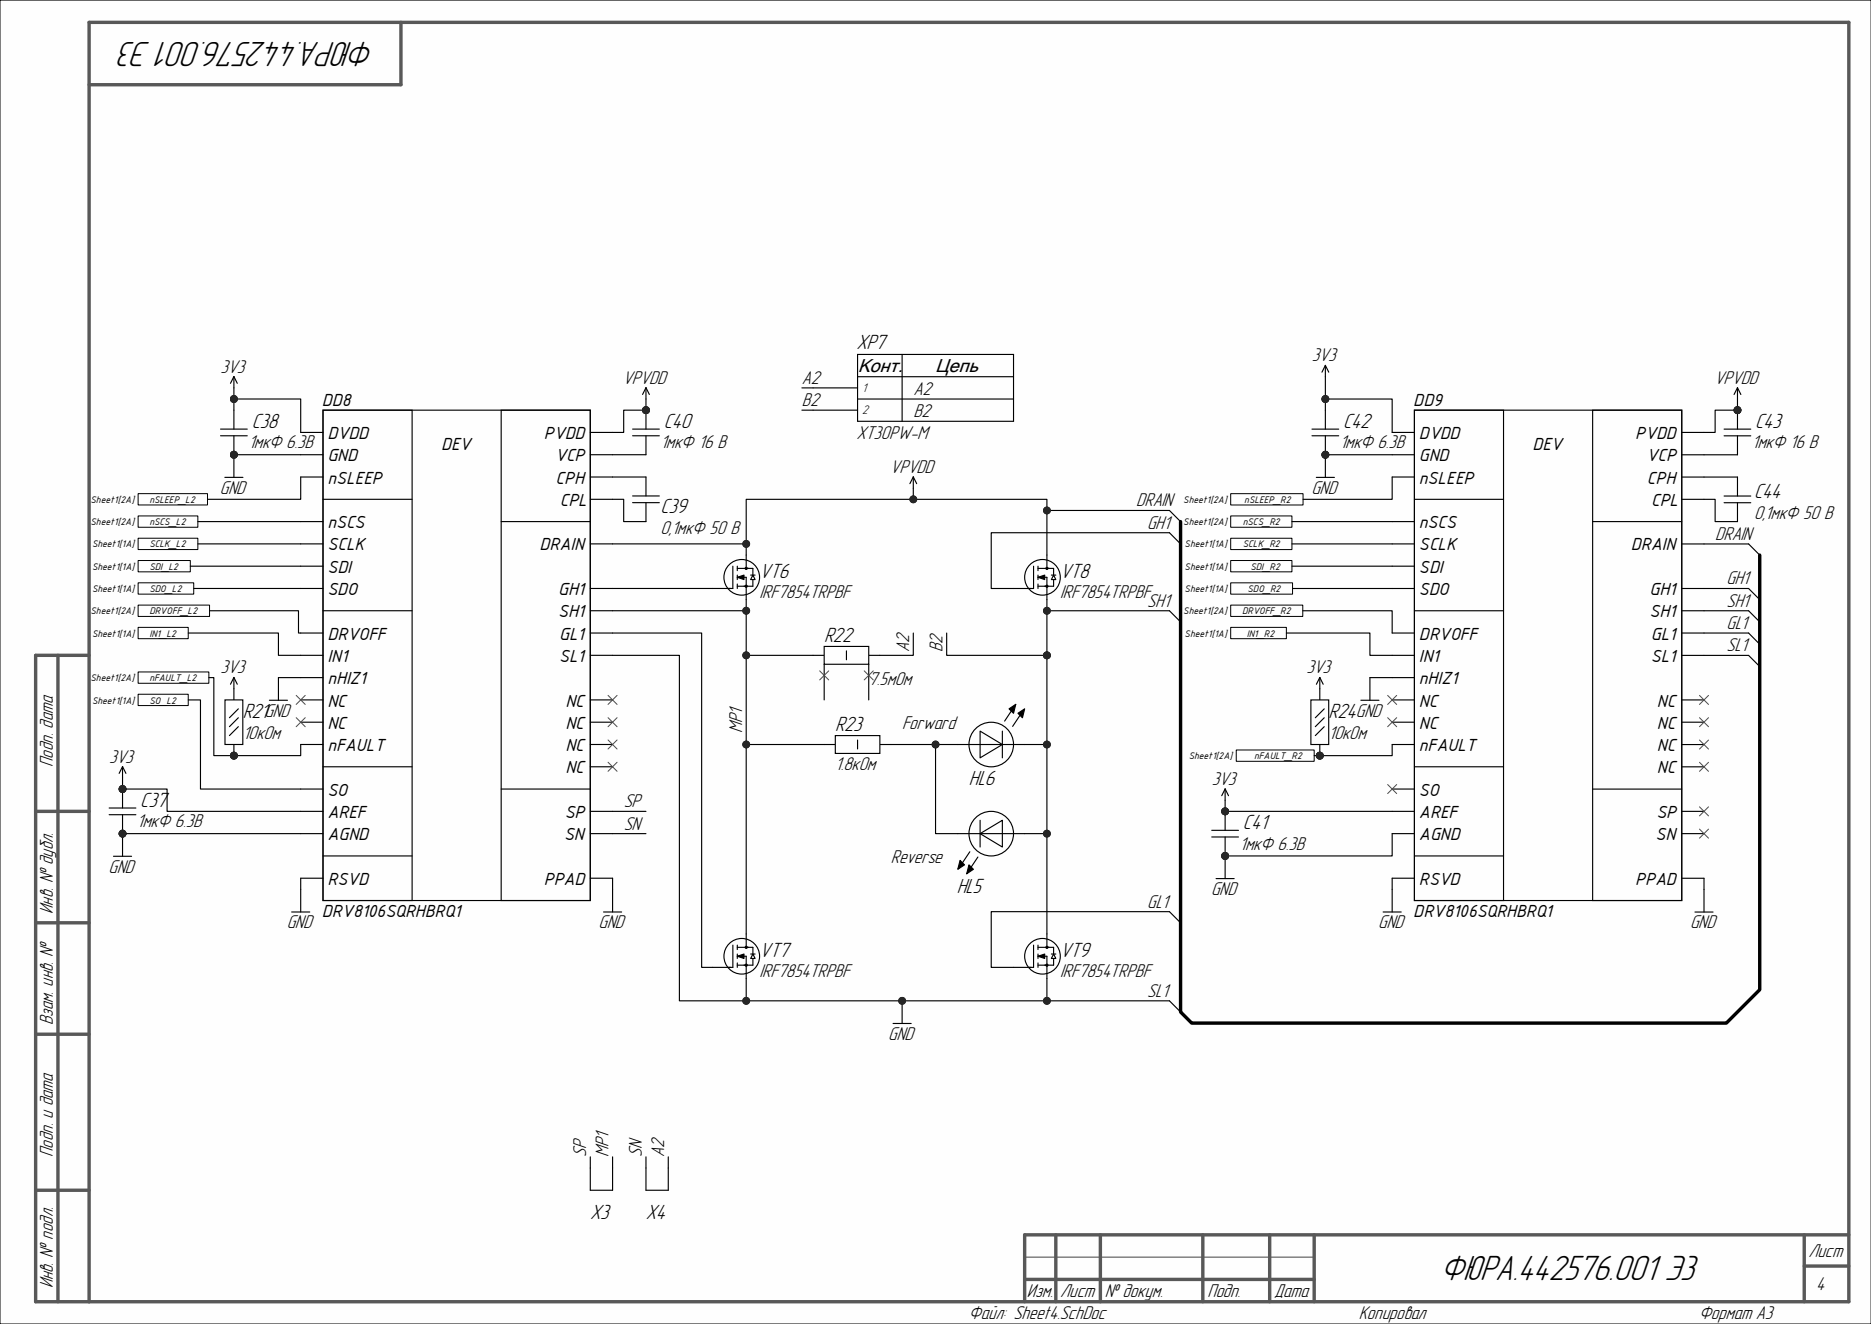
[picture p16: page 4]
