khripkinvlan/OvcharkaBoard/Schemes/sosa.pdf

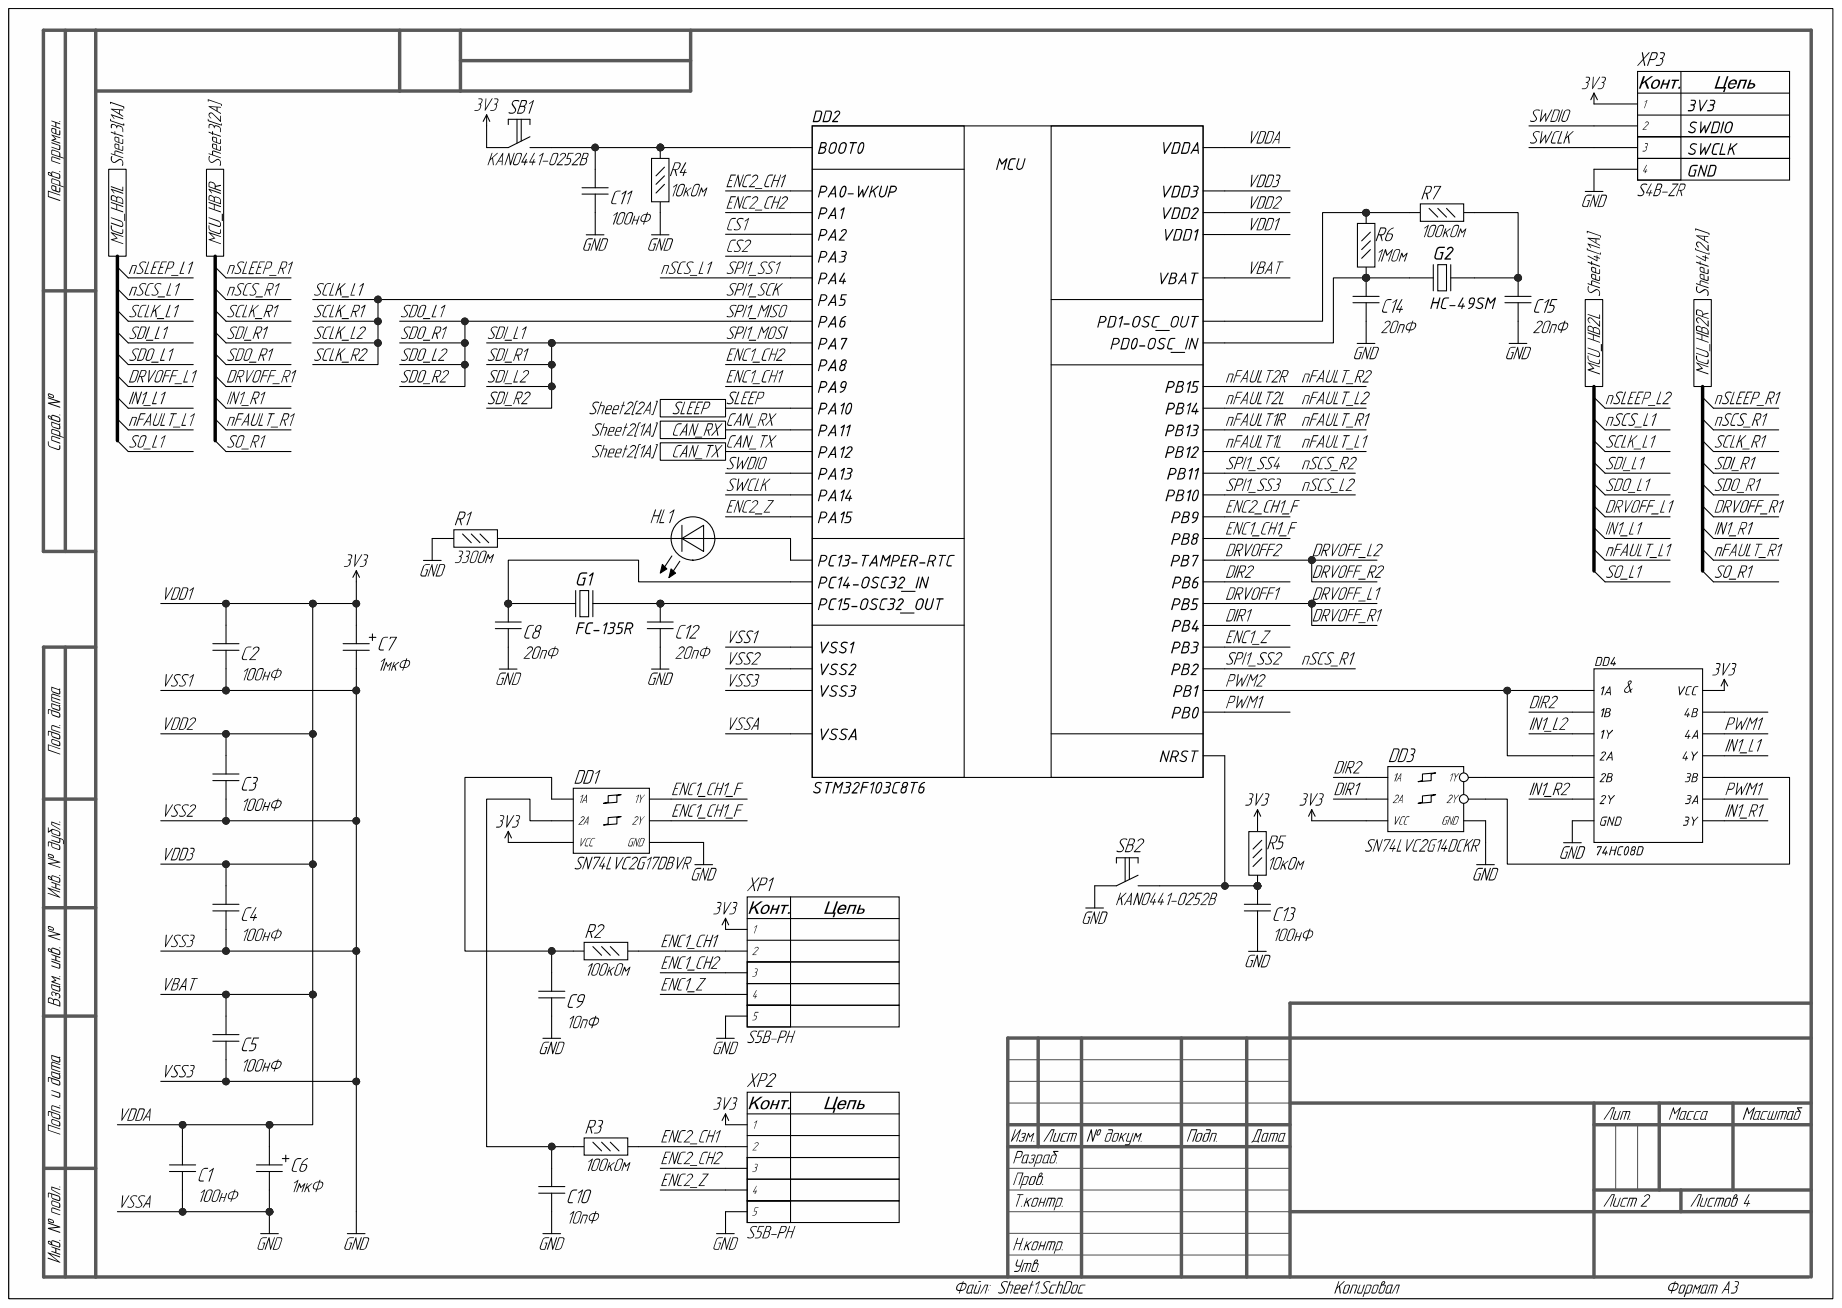
[picture p17: page 1]
