khripkinvlan/OvcharkaBoard/Schemes/Schemes_old2.pdf

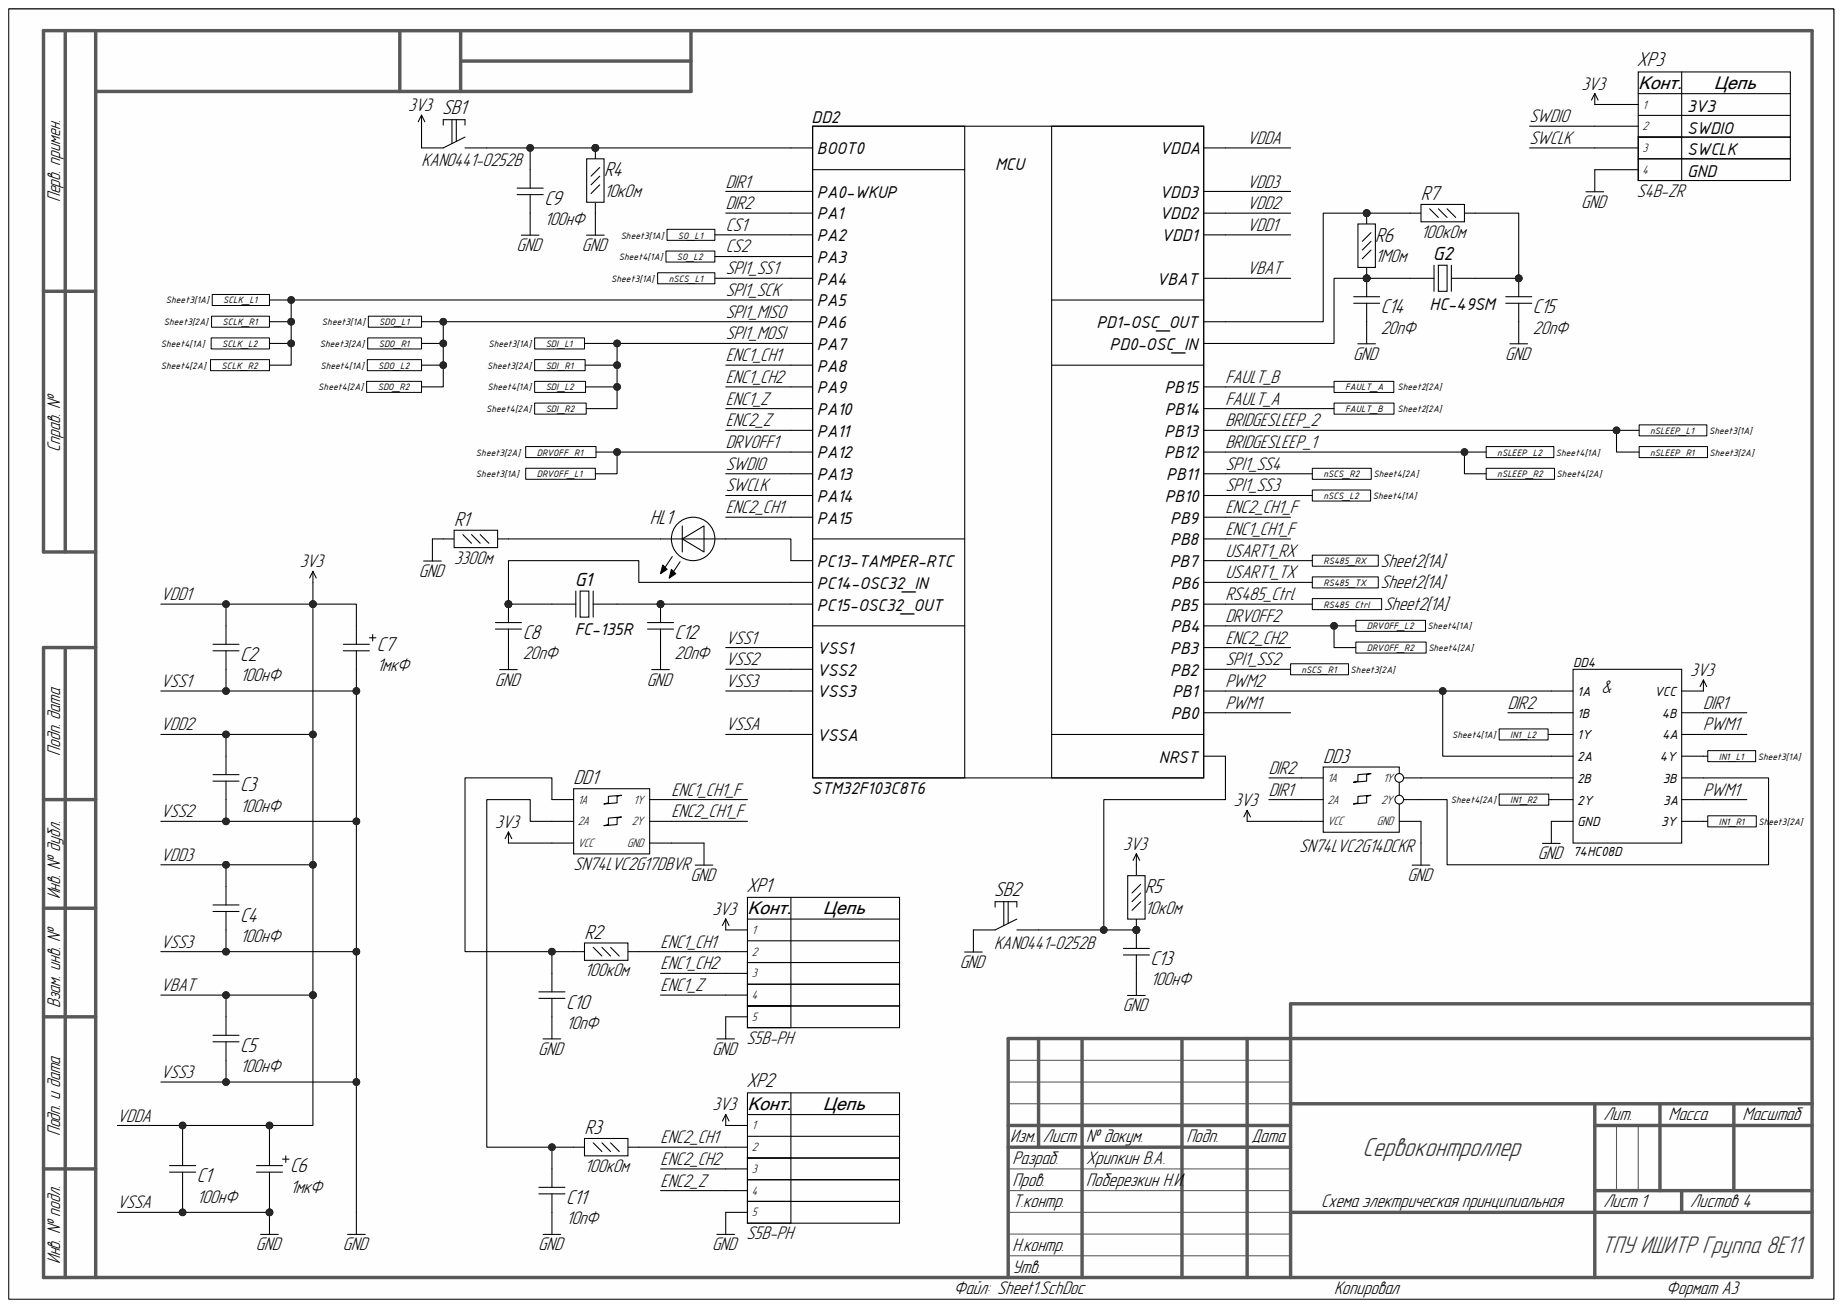
[picture p18: page 1]

Схема электрическая принципиальная Инв. № подл. Подп. и дата Взам. инв. № Инв. № дубл. Подп. дата Справ. № Перв. примен.

Сервоконтроллер | Лит. | Масса | Масштаб

Изм. Лист № докум. | | Подп. | Дата
Разраб. | Хрипкин В.А.
Пров. | Поберезкин Н.И.
Т.контр. | | | | Лист 1 4 | Листов

Н.контр.
Утв.

ТПУ ИШИТР Группа 8Е11

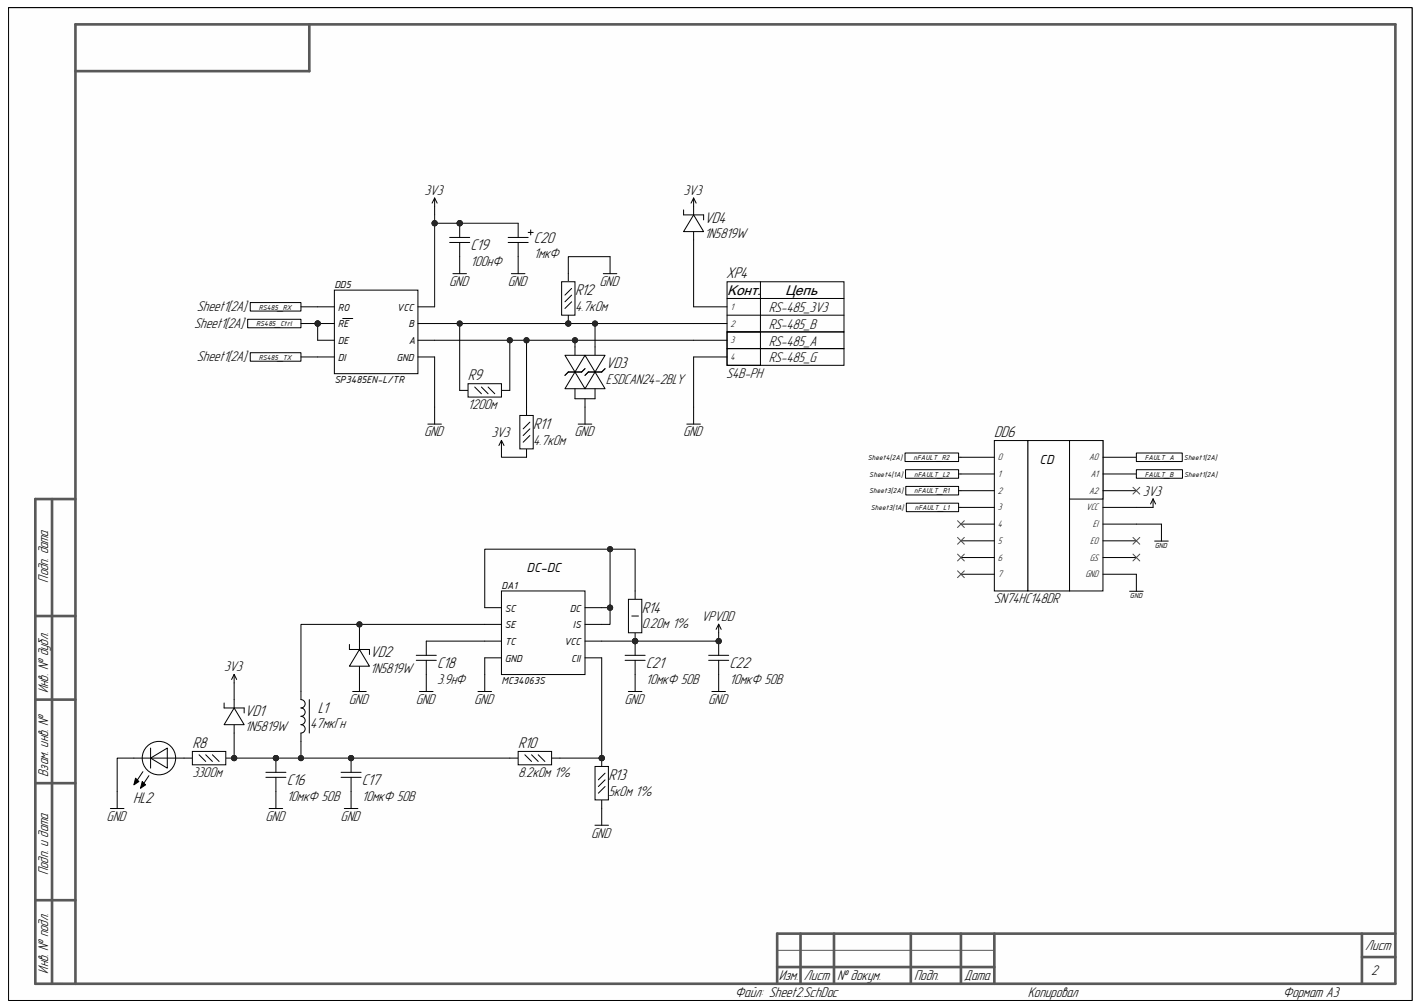
[picture p19: page 2]

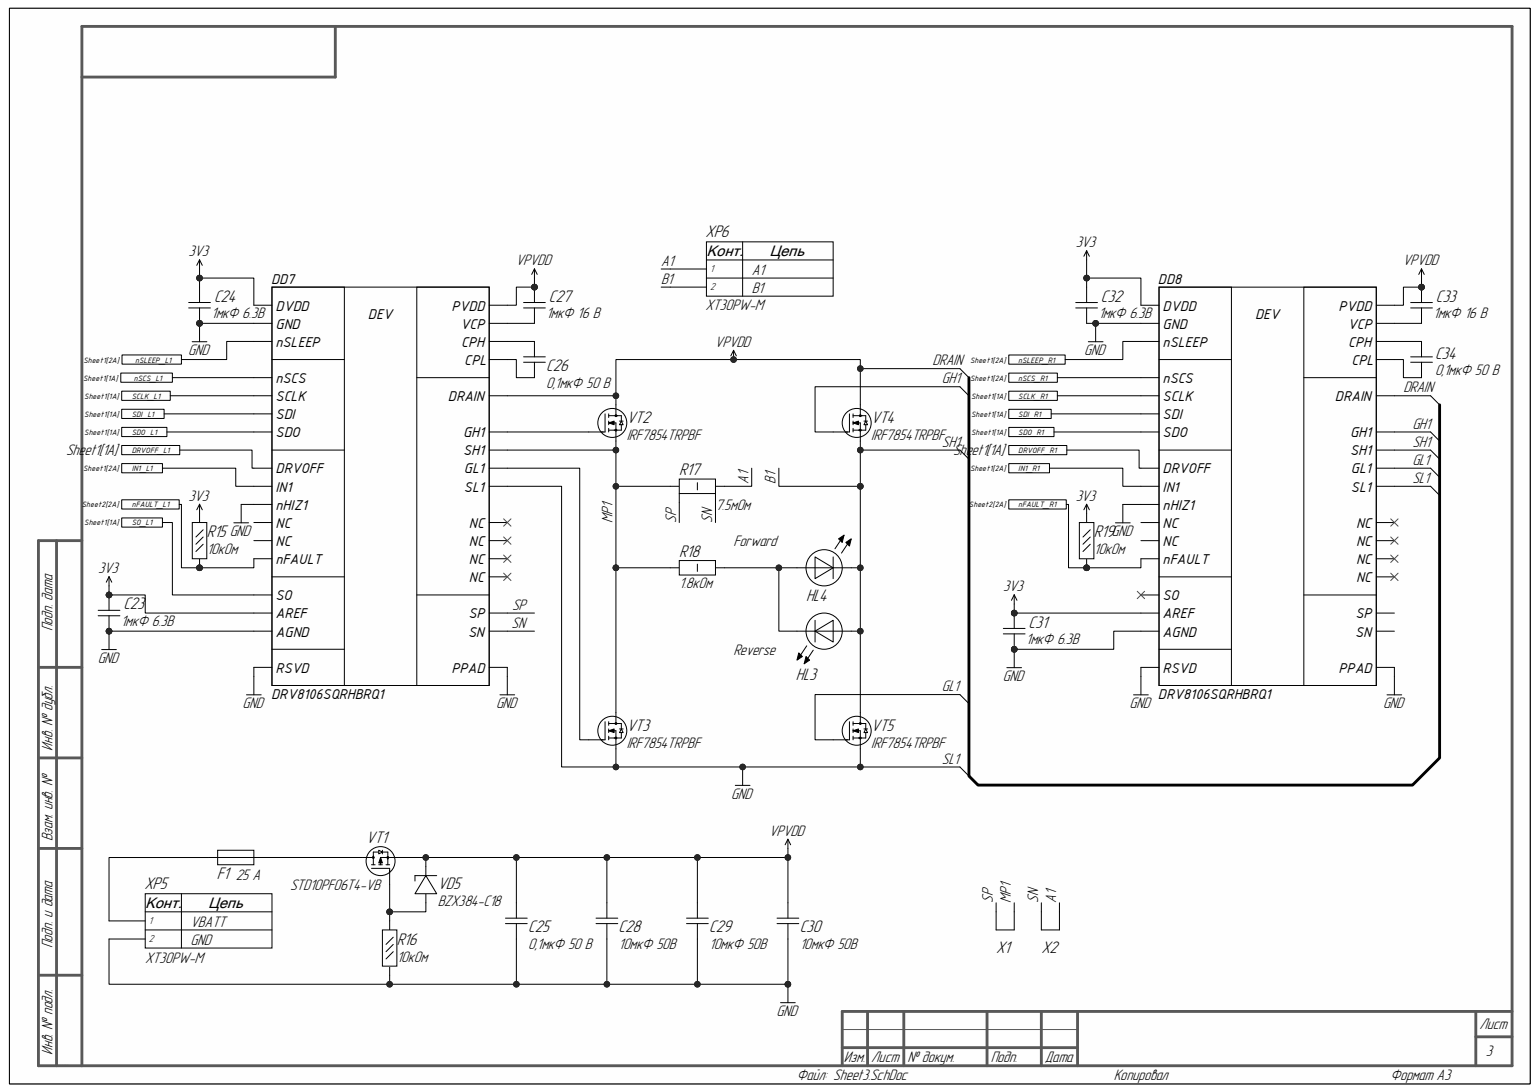
[picture p20: page 3]

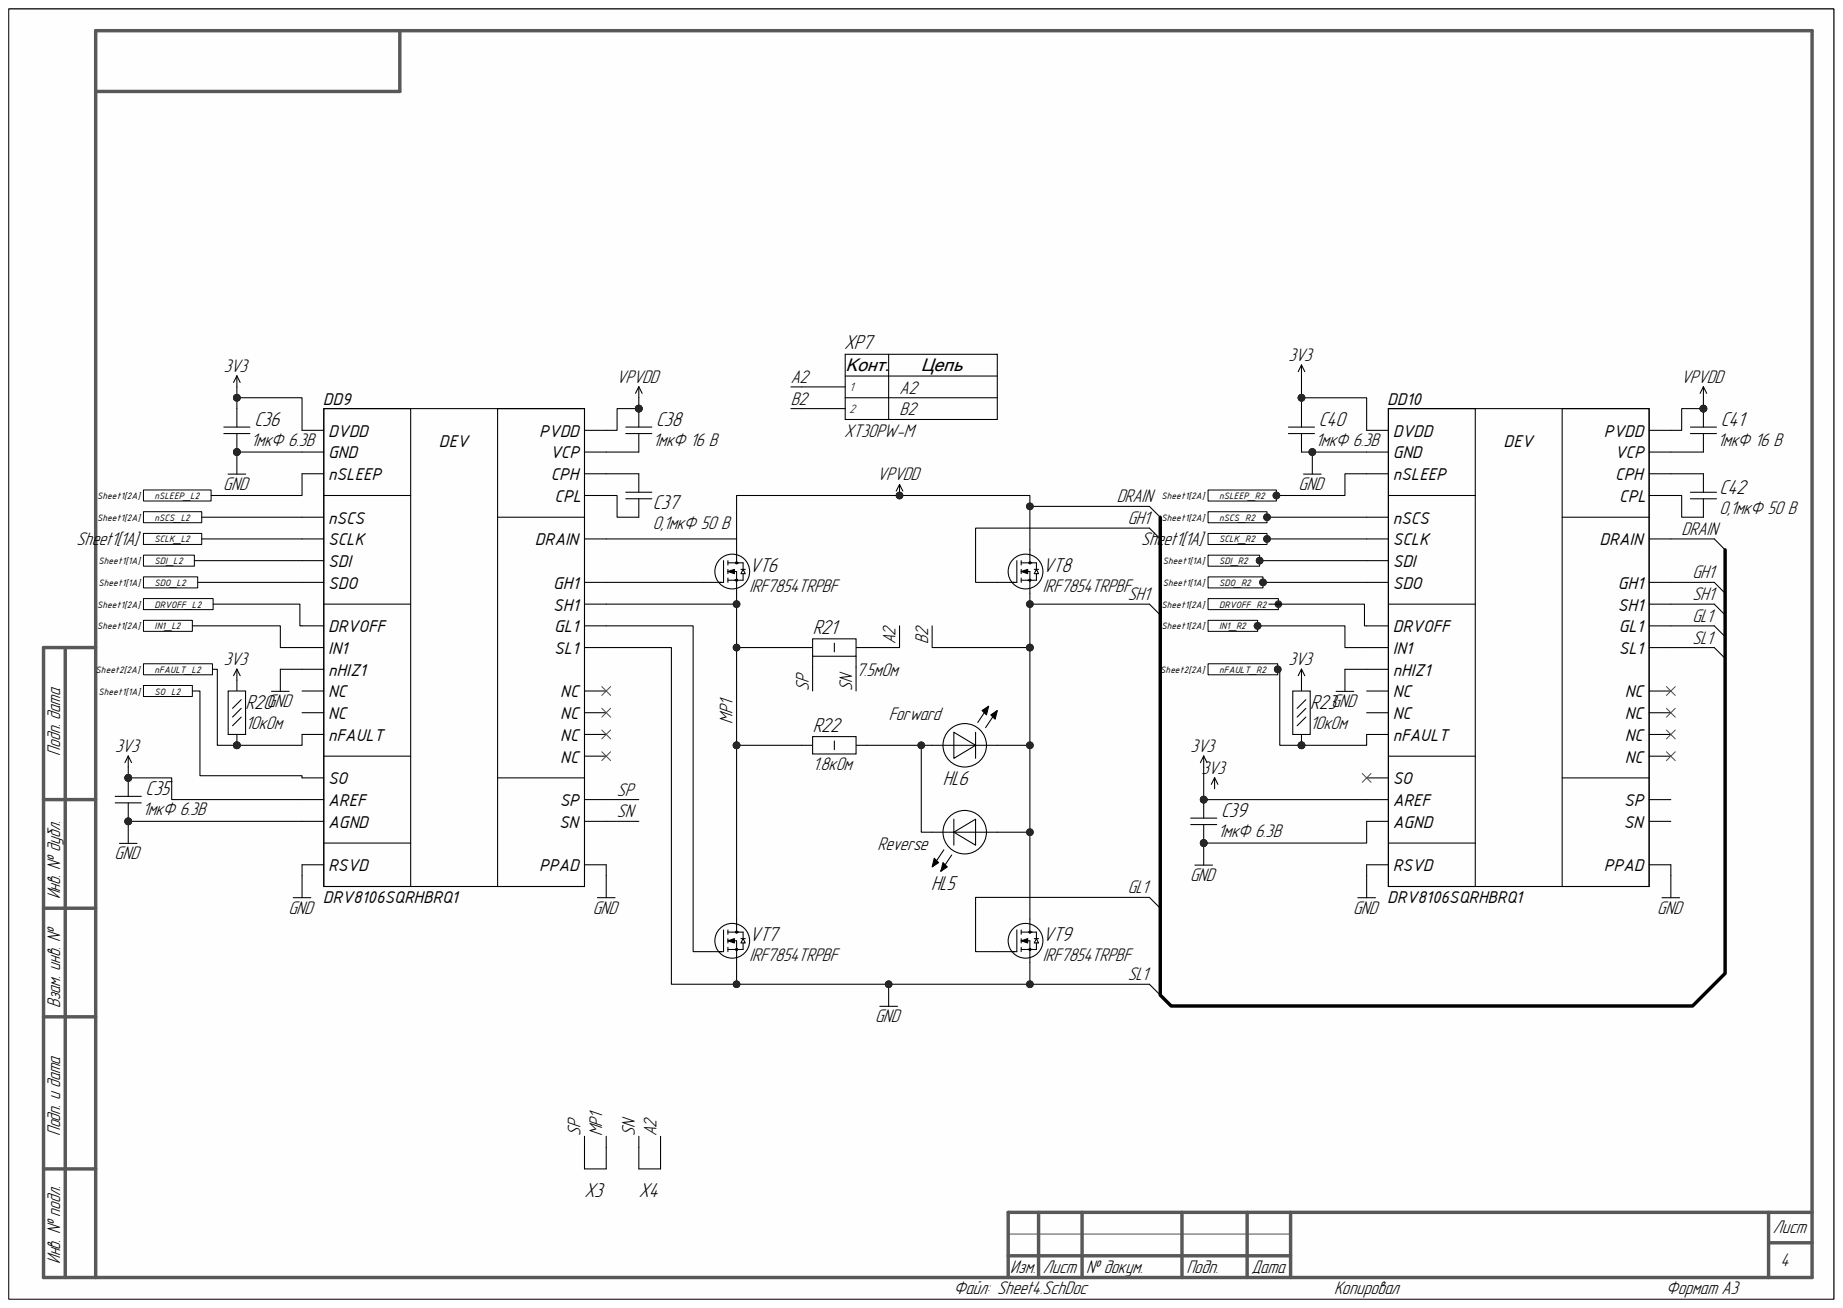
[picture p21: page 4]
