khripkinvlan/OvcharkaBoard/Schemes/Schemes_old.pdf

# SPDT 1P2T SLEEP Sheet1[1A]

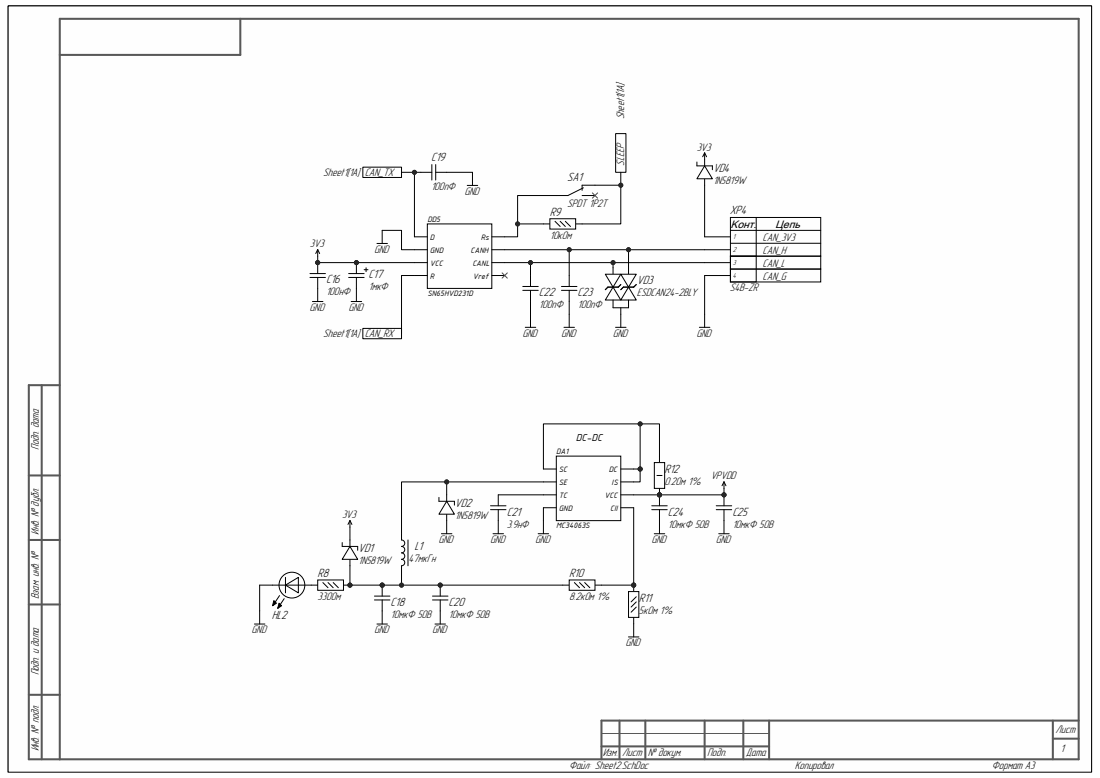
[picture p22: page 1]

# SO_R1 MCU_HB¹R Sheet3[2A]

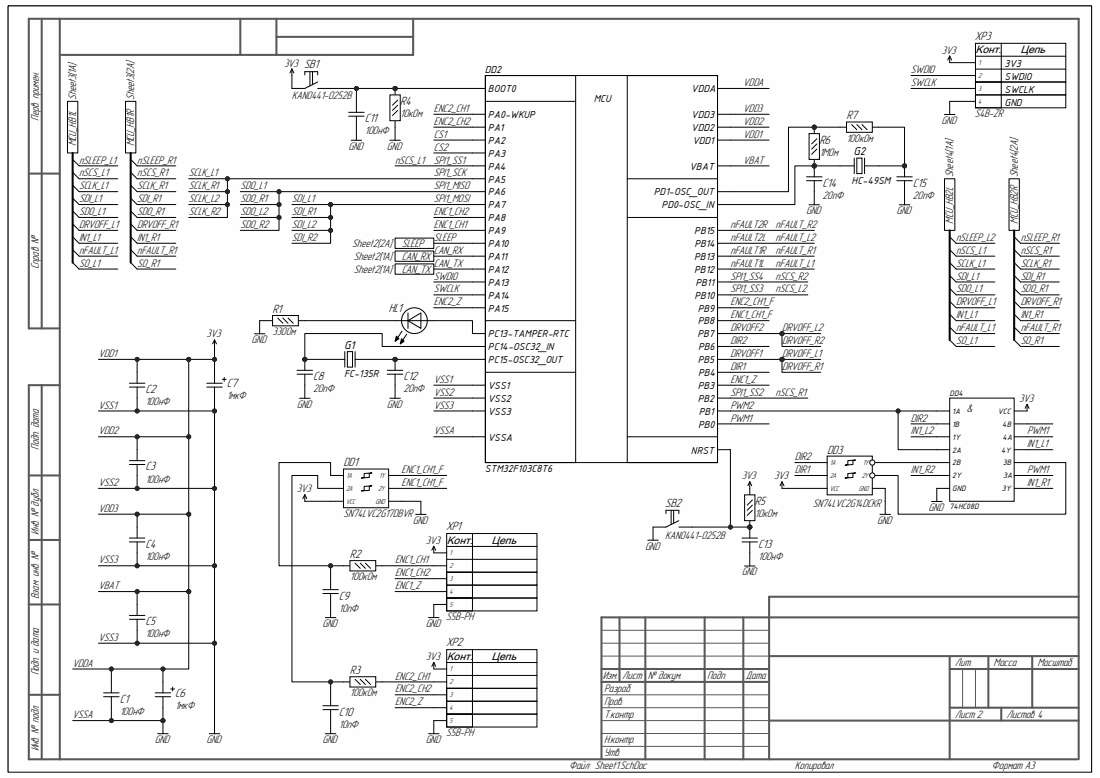
[picture p23: page 2]

Лит. | Масса | Масштаб

Изм. Лист № докум. | Подп. | Дата
Разраб.
Пров.
Т.контр.

Н.контр.
Утв.

# 3V3 MCU_HB¹L Sheet1[1A]

# 3V3 MCU_HB¹R Sheet1[1A]

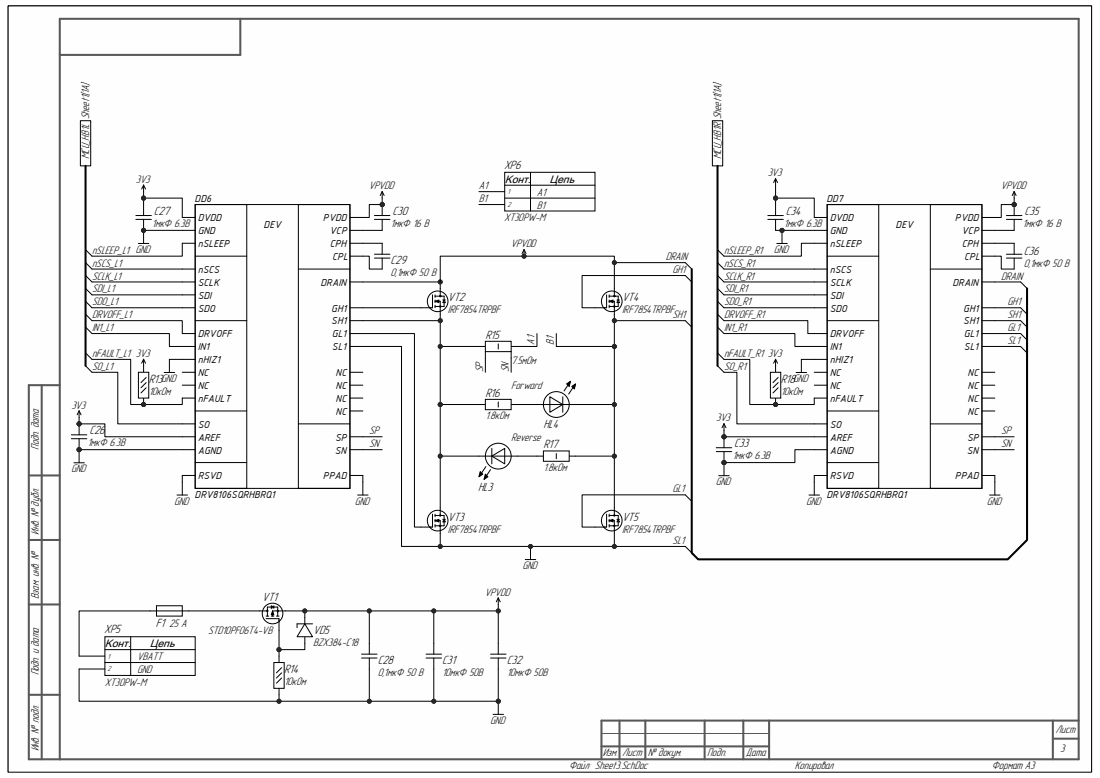
[picture p24: page 3]

# 3V3 MCU_HB2L Sheet1[2A]

# 3V3 MCU_HB2R Sheet1[2A]

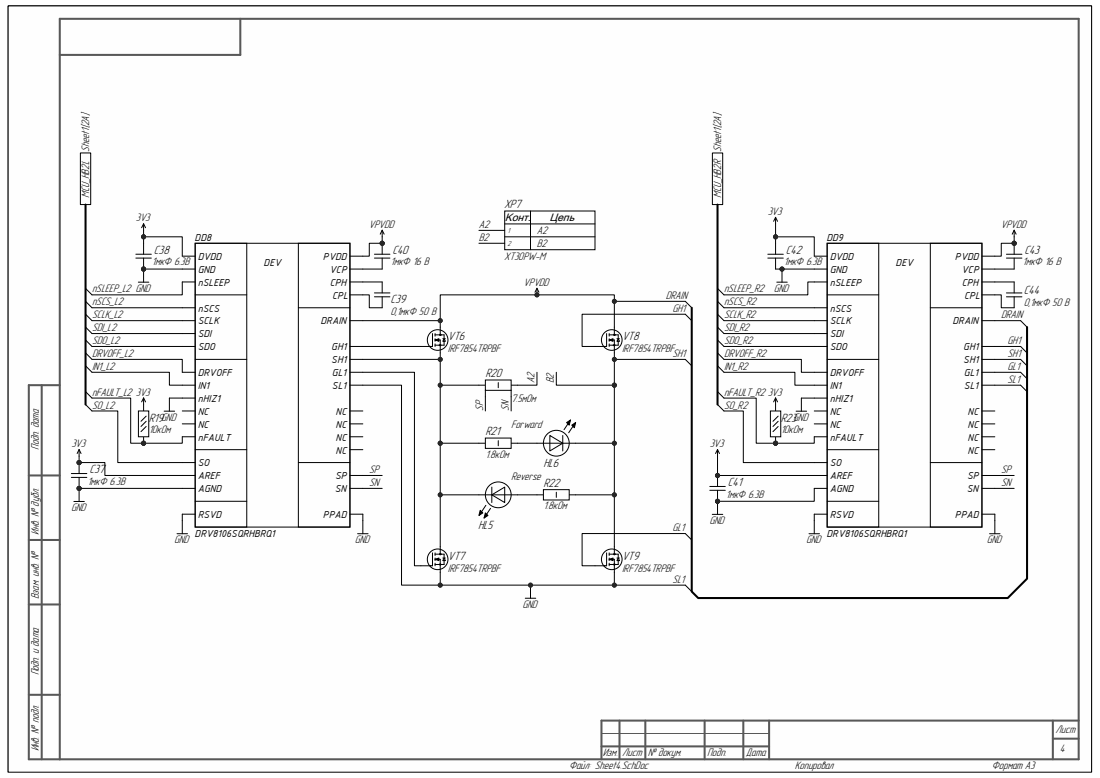
[picture p25: page 4]
