khripkinvlan/OvcharkaBoard/Schemes/Schemes_old1.pdf

# SO_R1 MCU_HB¹R Sheet3[2A]

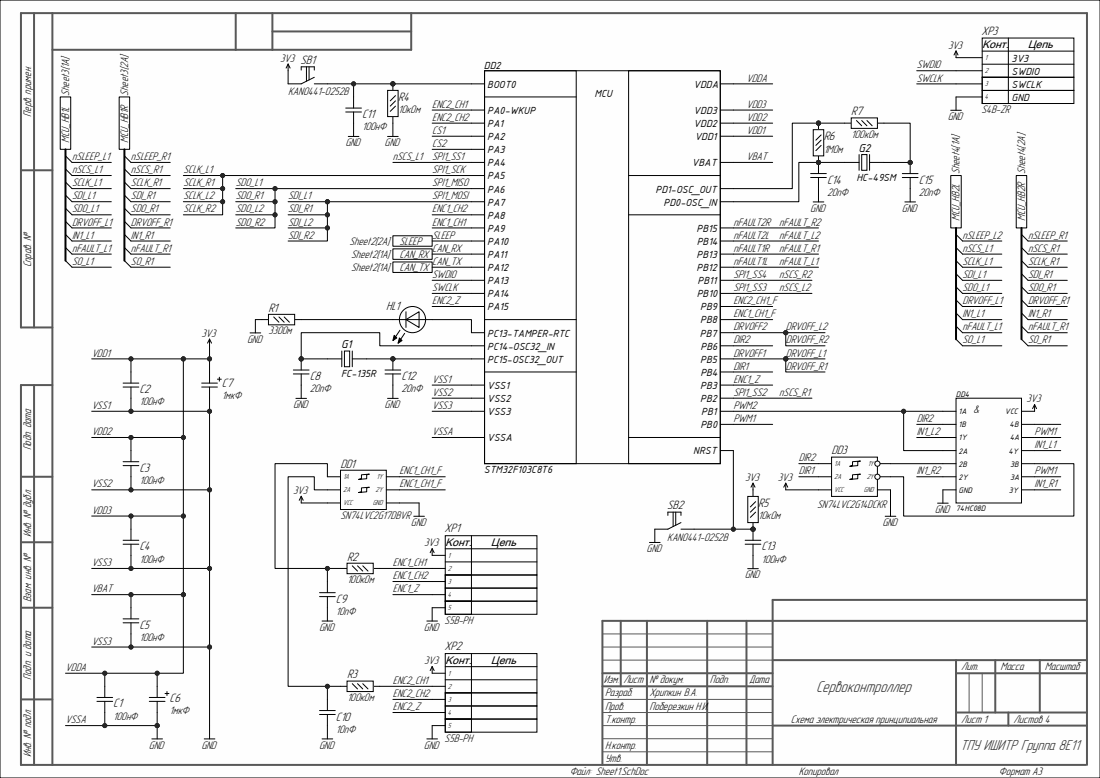
[picture p26: page 1]

Схема электрическая принципиальная Инв. № подл. Подп. и дата Взам. инв. № Инв. № дубл. Подп. дата Справ. № Перв. примен.

Сервоконтроллер | Лит. | Масса | Масштаб

Изм. Лист № докум. | | Подп. | Дата
Разраб. | Хрипкин В.А.

Н.контр.
Утв.

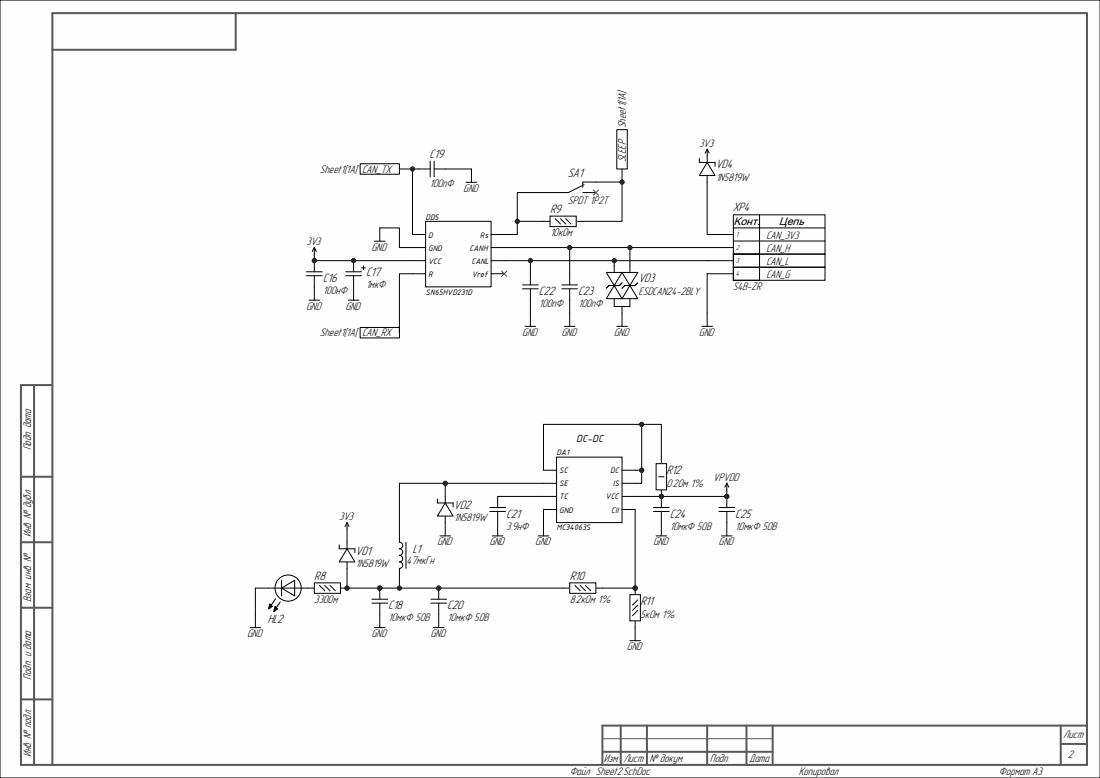
[picture p27: page 2]

# 3V3 MCU_HB¹L Sheet1[1A]

# 3V3 MCU_HB¹R Sheet1[1A]

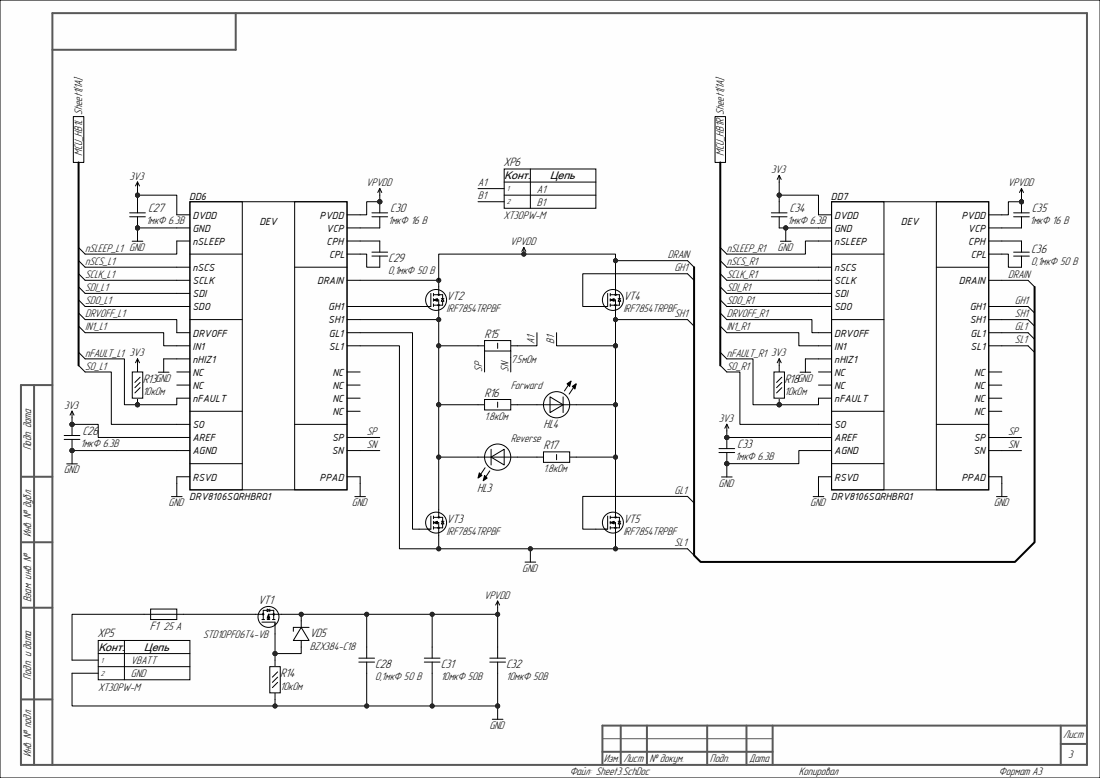
[picture p28: page 3]

# 3V3 MCU_HB2L Sheet1[2A]

# 3V3 MCU_HB2R Sheet1[2A]

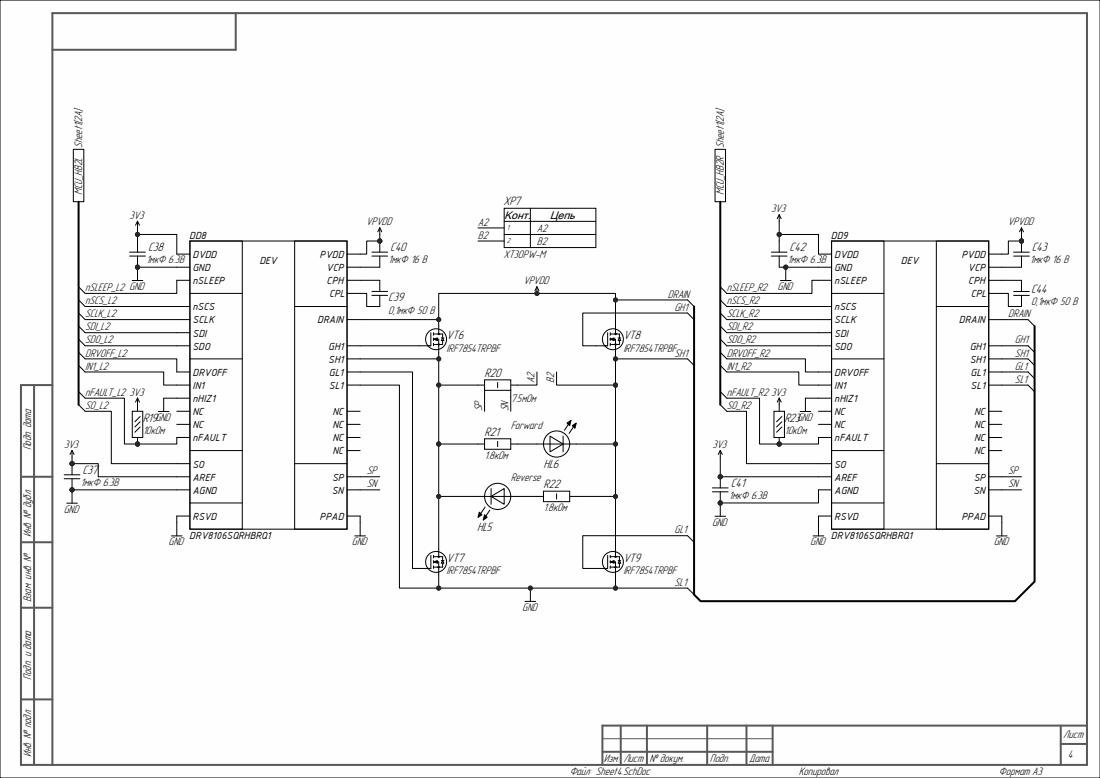
[picture p29: page 4]
