khripkinvlan/OvcharkaBoard/(list of files, drawings)

Other design files:
OvcharkaBoard/OvcharkaBoard.PcbDoc
OvcharkaBoard/OvcharkaBoard.PrjPcb
OvcharkaBoard/Sheet3.SchDoc
OvcharkaBoard/Лист 1.SchDoc
OvcharkaBoard/Лист 2.SchDoc
OvcharkaBoard/Лист 3.SchDoc
OvcharkaBoard/Лист 4.SchDoc
