khripkinvlan/OvcharkaBoard/ovcharka-firmware/Core/Src/main.c

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
/* Includes ------------------------------------------------------------------*/
#include "main.h"
#include "adc.h"
#include "dma.h"
#include "spi.h"
#include "tim.h"
#include "usart.h"
#include "gpio.h"

/* USER CODE BEGIN Includes */
#include "drv8106.h"
#include "IQmathLib.h"
#include "main_init.h"
#include "ind_led.h"
/* USER CODE END Includes */


/* USER CODE BEGIN PV */

// uint16_t duty1, duty2, dir1, dir2;
_iq18 test_iq;
servo_iq18_t servo1_g, servo2_g;

/* USER CODE END PV */

void SystemClock_Config(void);
/**
  * @brief  The application entry point.
  * @retval int
  */
int main(void)
{

  /* MCU Configuration--------------------------------------------------------*/

  /* Reset of all peripherals, Initializes the Flash interface and the Systick. */
  HAL_Init();

  /* Configure the system clock */
  SystemClock_Config();

  /* Initialize all configured peripherals */
  MX_GPIO_Init();
  MX_DMA_Init();
  MX_ADC1_Init();
  MX_SPI1_Init();
  MX_TIM1_Init();
  MX_TIM2_Init();
  MX_TIM3_Init();
  MX_TIM4_Init();
  MX_USART1_UART_Init();
  /* USER CODE BEGIN 2 */

  TXOFF; // Turn off transceiver during init

  // Pull down all CS pins of drivers
  HAL_GPIO_WritePin(SPI1_SS1_GPIO_Port, SPI1_SS1_Pin, GPIO_PIN_SET);
  HAL_GPIO_WritePin(SPI1_SS2_GPIO_Port, SPI1_SS2_Pin, GPIO_PIN_SET);
  HAL_GPIO_WritePin(SPI1_SS3_GPIO_Port, SPI1_SS3_Pin, GPIO_PIN_SET);
  HAL_GPIO_WritePin(SPI1_SS4_GPIO_Port, SPI1_SS4_Pin, GPIO_PIN_SET);
  HAL_Delay(1);

  // Wake up drivers
  HAL_GPIO_WritePin(BRIDGESLEEP1_GPIO_Port, BRIDGESLEEP1_Pin, GPIO_PIN_SET);
  HAL_GPIO_WritePin(BRIDGESLEEP2_GPIO_Port, BRIDGESLEEP2_Pin, GPIO_PIN_SET);

  // Turn high nHIZ pins, allowing the driver to switch on pwm command
  HAL_GPIO_WritePin(HIZ1_GPIO_Port, HIZ1_Pin, GPIO_PIN_SET);
  HAL_GPIO_WritePin(HIZ2_GPIO_Port, HIZ2_Pin, GPIO_PIN_SET);
  HAL_Delay(1);

  // Write defaults to all bridges in case MCU was reset
  drv8106_reset_blocking(&drv_l1_dd6);
  drv8106_reset_blocking(&drv_r1_dd7);
  drv8106_reset_blocking(&drv_l2_dd8);
  drv8106_reset_blocking(&drv_r2_dd9);

  // Clear faults (since there is power-on-reset fault at start)
  drv8106_clear_fault_blocking(&drv_l1_dd6);
  drv8106_clear_fault_blocking(&drv_r1_dd7);
  drv8106_clear_fault_blocking(&drv_l2_dd8);
  drv8106_clear_fault_blocking(&drv_r2_dd9);

  // read all registers of a driver
  drv8106_read_all_blocking(&drv_l1_dd6);
  drv8106_read_all_blocking(&drv_r1_dd7);
  drv8106_read_all_blocking(&drv_l2_dd8);
  drv8106_read_all_blocking(&drv_r2_dd9);

  // Enable current sensor with gain 10
  drv8106_CSA_enable_g10_blocking(&drv_l1_dd6);
  drv8106_CSA_enable_g10_blocking(&drv_r1_dd7);
  drv8106_CSA_enable_g10_blocking(&drv_l2_dd8);
  drv8106_CSA_enable_g10_blocking(&drv_r2_dd9);

  // Enable bridge to autorecover from most faults
  drv8106_set_fault_autorecovery_blocking(&drv_l1_dd6);
  drv8106_set_fault_autorecovery_blocking(&drv_r1_dd7);
  drv8106_set_fault_autorecovery_blocking(&drv_l2_dd8);
  drv8106_set_fault_autorecovery_blocking(&drv_r2_dd9);

  // Enable drivers via SPI bit
  drv8106_Enable_blocking(&drv_l1_dd6);
  drv8106_Enable_blocking(&drv_r1_dd7);
  drv8106_Enable_blocking(&drv_l2_dd8);
  drv8106_Enable_blocking(&drv_r2_dd9);
  HAL_Delay(1);

  // Init led indication module
  ind_led_init(&ind_led_red, IND_LED_GPIO_Port, IND_LED_Pin, 250, 0);

  // Init stuff for motor control
  init_mtr_ctrl();

  /* USER CODE END 2 */

  /* Infinite loop */
  /* USER CODE BEGIN WHILE */
  while (1)
  {
    /* USER CODE END WHILE */

    /* USER CODE BEGIN 3 */
  }
  /* USER CODE END 3 */
}

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
/* USER CODE BEGIN 4 */

// void HAL_TIM_PeriodElapsedCallback(TIM_HandleTypeDef *htim)
// {
//   if(htim == &htim3){
//     static uint16_t cntr = 0;
//     cntr++;
//     if (cntr >= 3600){
//       HAL_GPIO_TogglePin(IND_LED_GPIO_Port, IND_LED_Pin);
//       cntr = 0;
//     }

//     fault1 = HAL_GPIO_ReadPin(nFAULT_L1_GPIO_Port, nFAULT_L1_Pin);
//     fault2 = HAL_GPIO_ReadPin(nFAULT_R1_GPIO_Port, nFAULT_R1_Pin);
//     fault3 = HAL_GPIO_ReadPin(nFAULT_L2_GPIO_Port, nFAULT_L2_Pin);
//     fault4 = HAL_GPIO_ReadPin(nFAULT_R2_GPIO_Port, nFAULT_R2_Pin);

//     TIM3->CCR1 = duty1;
//     TIM3->CCR2 = duty2;
//     HAL_GPIO_WritePin(DIR1_1_GPIO_Port, DIR1_1_Pin, dir1);   
//     HAL_GPIO_WritePin(DIR2_1_GPIO_Port, DIR2_1_Pin, dir2);   

//   }
  
// }

/* USER CODE END 4 */
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
