khripkinvlan/OvcharkaBoard/ovcharka-firmware/mcuviewer-ovcharka.cfg

[elf]
file_path = C:/Github/OvcharkaBoard/ovcharka-firmware/build/ovcharka-firmware.elf

[settings]
version = 1
sample_frequency_hz = 1000
max_points = 10000
max_viewport_points = 5000
refresh_on_elf_change = true
stop_acq_on_elf_change = true
probe_type = 0
target_name = 
probe_mode = 0
probe_speed_khz = 10000
probe_sn = 670034000900004A4735544E
should_log = false
log_directory = 
gdb_command = gdb

[trace_settings]
core_frequency = 160000
trace_prescaler = 10
max_points = 10000
max_viewport_points_percent = 10
trigger_channel = -1
trigger_level = 0.900000
timeout = 2
probe_type = 0
target_name = 
probe_speed_khz = 10000
probe_sn = 
should_log = false
log_directory = 

[var0]
name = adc[0]
tracked_name = adc[0]
address = 536871252
type = 3
color = 2615718173
should_update_from_elf = true
shift = 0
mask = 4294967295
high_level_type = 0

[var1]
name = adc[1]
tracked_name = adc[1]
address = 536871254
type = 3
color = 3144903575
should_update_from_elf = true
shift = 0
mask = 4294967295
high_level_type = 0

[var2]
name = ang_debug_set_1
tracked_name = ang_debug_set_1
address = 536871292
type = 7
color = 146818643
should_update_from_elf = true
shift = 0
mask = 4294967295
high_level_type = 0

[var3]
name = ang_debug_set_2
tracked_name = ang_debug_set_2
address = 536871288
type = 7
color = 3050302839
should_update_from_elf = true
shift = 0
mask = 4294967295
high_level_type = 0

[var4]
name = axis_define
tracked_name = axis_define
address = 536871256
type = 1
color = 751457406
should_update_from_elf = true
shift = 0
mask = 4294967295
high_level_type = 0

[var5]
name = brg_fault_flag
tracked_name = brg_fault_flag
address = 536871258
type = 1
color = 760457566
should_update_from_elf = true
shift = 0
mask = 4294967295
high_level_type = 0

[var6]
name = bus_crc_history
tracked_name = bus_crc_history
address = 536871068
type = 5
color = 14085742
should_update_from_elf = true
shift = 0
mask = 4294967295
high_level_type = 0

[var7]
name = comms_fault_flag
tracked_name = comms_fault_flag
address = 536871257
type = 1
color = 535344719
should_update_from_elf = true
shift = 0
mask = 4294967295
high_level_type = 0

[var8]
name = crc_check_debug
tracked_name = crc_check_debug
address = 536871890
type = 0
color = 1749655931
should_update_from_elf = true
shift = 0
mask = 4294967295
high_level_type = 0

[var9]
name = cur_debug_set_1
tracked_name = cur_debug_set_1
address = 536871308
type = 7
color = 2581965525
should_update_from_elf = true
shift = 0
mask = 4294967295
high_level_type = 0

[var10]
name = cur_debug_set_2
tracked_name = cur_debug_set_2
address = 536871304
type = 7
color = 3886346034
should_update_from_elf = true
shift = 0
mask = 4294967295
high_level_type = 0

[var11]
name = current[0]
tracked_name = current[0]
address = 536871244
type = 6
color = 3527260667
should_update_from_elf = true
shift = 0
mask = 4294967295
high_level_type = 1
frac = 18
base = 1.000000
base_variable = 

[var12]
name = current[1]
tracked_name = current[1]
address = 536871248
type = 6
color = 2016687347
should_update_from_elf = true
shift = 0
mask = 4294967295
high_level_type = 1
frac = 18
base = 1.000000
base_variable = 

[var13]
name = data_ctrl.velocity_1
tracked_name = data_ctrl.velocity_1
address = 536871921
type = 4
color = 3574154180
should_update_from_elf = true
shift = 0
mask = 4294967295
high_level_type = 0

[var14]
name = data_ctrl.velocity_2
tracked_name = data_ctrl.velocity_2
address = 536871927
type = 4
color = 90026786
should_update_from_elf = true
shift = 0
mask = 4294967295
high_level_type = 0

[var15]
name = data_ctrl_unchecked.ID
tracked_name = data_ctrl_unchecked.ID
address = 536871932
type = 1
color = 2631403419
should_update_from_elf = true
shift = 0
mask = 4294967295
high_level_type = 0

[var16]
name = data_ctrl_unchecked.angle1
tracked_name = data_ctrl_unchecked.angle1
address = 536871938
type = 0
color = 476881433
should_update_from_elf = true
shift = 0
mask = 4294967295
high_level_type = 0

[var17]
name = data_ctrl_unchecked.angle2
tracked_name = data_ctrl_unchecked.angle2
address = 536871944
type = 0
color = 2529857
should_update_from_elf = true
shift = 0
mask = 4294967295
high_level_type = 0

[var18]
name = data_ctrl_unchecked.angle3
tracked_name = data_ctrl_unchecked.angle3
address = 536871950
type = 0
color = 4150685331
should_update_from_elf = true
shift = 0
mask = 4294967295
high_level_type = 0

[var19]
name = data_ctrl_unchecked.angle4
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
visibility = true
domain = 1

[trace_plot6]
name = CH6
alias = CH6
visibility = true
domain = 1

[trace_plot7]
name = CH7
alias = CH7
visibility = true
domain = 1

[trace_plot8]
name = CH8
alias = CH8
visibility = true
domain = 1

[trace_plot9]
name = CH9
alias = CH9
visibility = true
domain = 1
