khripkinvlan/OvcharkaBoard/ovcharka-firmware/Core/Inc/global_flags.h

#ifndef INC_GLOBAL_FLAGS_H_
#define INC_GLOBAL_FLAGS_H_

#include "main.h"

extern volatile uint8_t system_enabled;
extern volatile uint8_t control_mode;
extern volatile uint8_t reset_flag;
extern volatile uint8_t brg_fault_flag;
extern volatile uint8_t comms_fault_flag;
extern volatile uint8_t overcurrent_flag;
extern volatile uint8_t axis_define;

#endif /* INC_GLOBAL_FLAGS_H_ */
