khripkinvlan/OvcharkaBoard/ovcharka-firmware/Core/Inc/loops_handler.h

#ifndef INC_LOOPS_HANDLER_H_
#define INC_LOOPS_HANDLER_H_

#include "tim.h"
#include "IQmathLib.h"
#include "main_init.h"
#include "ind_led.h"
#include "potamon_bus_lowlvl_handle.h"


#endif /* INC_LOOPS_HANDLER_H_ */
