khripkinvlan/OvcharkaBoard/ovcharka-firmware/Core/Src/pwm.c

/*
 * pwm.c
 *
 *  Created on: 28/06//2023
 *      Author: JV4K
 */
#include <pwm.h>
#define constrain(amt,low,high) ((amt)<(low)?(low):((amt)>(high)?(high):(amt)))
#define ABS(N) ((N<0)?(-N):(N))

void pwm_initDriver(pwmControl_t *driver, TIM_HandleTypeDef *htim, uint8_t pwmChannel,
	GPIO_TypeDef *dir1_Port, uint32_t dir1_Pin) {
	driver->dir1_Port = dir1_Port;
	driver->dir1_Pin = dir1_Pin;

	driver->htim = htim;
	driver->timerChannel = pwmChannel;
}

void pwm_dutyLimits(pwmControl_t *driver, uint16_t minDuty, uint16_t maxDuty) {
	driver->minDuty = minDuty;
	driver->maxDuty = maxDuty;
}

void pwm_setSpeed(pwmControl_t *driver, int32_t duty) {
	if (!duty) {
		driver->_duty = 0;
		driver->dir = 0;
	} else {
		driver->_duty = constrain(ABS(duty), driver->minDuty, driver->maxDuty);
		if (duty > 0) {
			HAL_GPIO_WritePin(driver->dir1_Port, driver->dir1_Pin, 1);
			driver->dir = 1;
		} else {
			HAL_GPIO_WritePin(driver->dir1_Port, driver->dir1_Pin, 0);
			driver->dir = -1;
		}
	}

	switch (driver->timerChannel) {
	case 1:
		driver->htim->Instance->CCR1 = driver->_duty;
		break;
	case 2:
		driver->htim->Instance->CCR2 = driver->_duty;
		break;
	case 3:
		driver->htim->Instance->CCR3 = driver->_duty;
		break;
	case 4:
		driver->htim->Instance->CCR4 = driver->_duty;
		break;
	default:
		break;
	}
}
