khripkinvlan/OvcharkaBoard/(commit log)

2024-03-24 dc dc done
    [OvcharkaBoard.PrjPcb, Sheet1.SchDoc, Sheet2.SchDoc, Sheet3.SchDoc, Sheet4.SchDoc, shuntCalc.xlsx]
2024-03-29 SchemesDone v0.1
    [OvcharkaBoard.PrjPcb, Sheet1.SchDoc, Sheet2.SchDoc, Sheet3.SchDoc, Sheet4.SchDoc]
2024-11-28 Final steps left
    [OvcharkaBoard.PrjPcb, Sheet1.SchDoc, Sheet2.SchDoc, Sheet3.SchDoc, Sheet4.SchDoc, bomchik.xlsx]
2024-12-02 Rework started
    [OvcharkaBoard.PrjPcb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]
2025-01-27 schemes and other
    [BomhcikReworked.xlsx, cam.dxf]
2025-02-23 Create Инвентаризация 23.02.2025.xlsx
    [Инвентаризация 23.02.2025.xlsx]
2025-02-28 added datasheet for drv8106, started driver dev
2025-03-14 CS done
    [Sheet3.SchDoc]
2025-03-18 first good vel control run
    [mcuviewer-ovcharka.cfg]
2025-03-18 tweaks, preparing for new current filter
    [mcuviewer-ovcharka.cfg]
2025-03-19 somewhat stable before IC implementation
    [mcuviewer-ovcharka.cfg]
2025-03-27 somewhat final
    [mcuviewer-ovcharka.cfg]
2025-04-02 bus comms fixed!!
    a single debug func took too long and desynced axis 1 controller
    [mcuviewer-ovcharka.cfg]
2025-04-06 Лист1
    [Sheet1.SchDoc]
2025-04-06 Лист1 (auto)
    [Лист1.SchDoc, Лист2.SchDoc]
2025-04-12 feedback signs issue resolved
    [potamon_bus_lowlvl_handle.c, settings.h]
